HecVelaz/Proyecto-Mburica-/02_Estacion/Proyecto3__Sistema_de_adquisiscion_de_Nivel/Evidencias_Pruebas/capturas/Base_de_datos_servidor.jpg

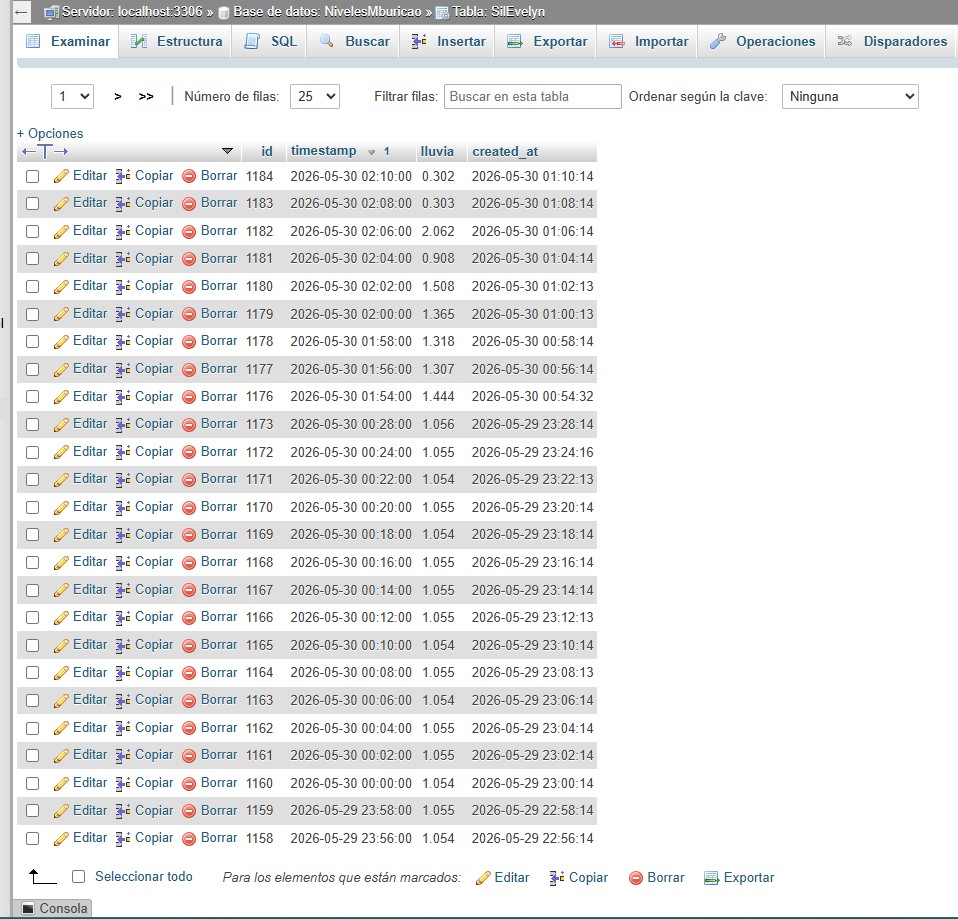
02_Estacion/Proyecto3__Sistema_de_adquisiscion_de_Nivel/Evidencias_Pruebas/capturas/Base_de_datos_servidor.jpg
