HecVelaz/Proyecto-Mburica-/02_Estacion/Proyecto3__Sistema_de_adquisiscion_de_Nivel/Evidencias_Pruebas/capturas/Montaje_sistema.jpg

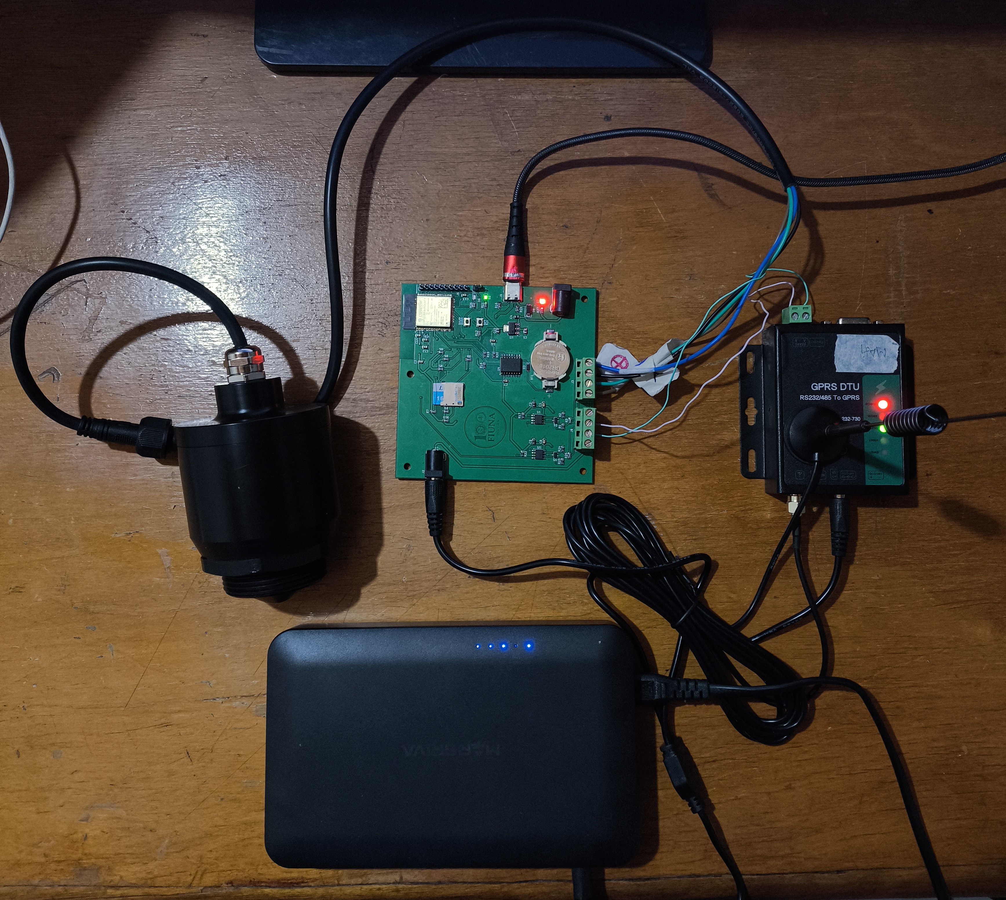
02_Estacion/Proyecto3__Sistema_de_adquisiscion_de_Nivel/Evidencias_Pruebas/capturas/Montaje_sistema.jpg
