HecVelaz/Proyecto-Mburica-/README.md

# Proyecto-Mburica-
Repositorio central del Proyecto Mburicao: Sistema IoT de monitoreo de nivel de cauces, modelos de predicción con IA y documentación científica
