HecVelaz/Proyecto-Mburica-/02_Estacion/Proyecto3__Sistema_de_adquisiscion_de_Nivel/Hardware_Kicad/placa_estacion/placa_estacion.md

## Propósito
En ésta carpeta se encuentran los archivos referentes al diseño del PCB para la placa de la estación
se utilizó la aplicación de escritorio EasyEDA, también se hizo la prueba con KiCAD pero finalmente se optó por EasyEDA.

## Contenido

- [[ESTACION2.rar]]
