HecVelaz/Proyecto-Mburica-/01_Modelos/notebooks/notebooks.md

[[aisp]]
[[csv_to_excel]]
[[features]]
[[Map Heat]]
[[merged]]
[[nivel]]
[[sil]]
[[snd]]
