HecVelaz/Proyecto-Mburica-/01_Modelos/notebooks/Map Heat/Map Heat.md

## Propósito
Alojamiento para guardar las imágenes del Cross Correlation de cada stación snd , aisp , sil
además del script Cross-Correlation-Map-Heat.ipynb

## Contenido
- [`Cross-Correlation-Map-Heat.ipynb`](notebooks/Map%20Heat/Cross-Correlation-Map-Heat.ipynb)
- [heatmap.png](heatmap.png)
- [heatmap_aisp_adjusted_bold_labels.png](heatmap_aisp_adjusted_bold_labels.png)
- [heatmap_sil_adjusted_bold_labels.png](heatmap_sil_adjusted_bold_labels.png)
- [heatmap_snd_adjusted_bold_labels.png](heatmap_snd_adjusted_bold_labels.png)
## Archivos relevantes

### Datos
- sin datos

### Notebooks
- [`Cross-Correlation-Map-Heat.ipynb`](notebooks/Map%20Heat/Cross-Correlation-Map-Heat.ipynb)

## Flujo de uso
Cómo se usan estos archivos en conjunto.
## Entradas
- 3 listas para cada estación 

## Salidas
- grafico mapa de calor de a cuerdo a la lista de entrada

## Observaciones
- Supuestos
- Limitaciones
- Notas importantes
