HecVelaz/Proyecto-Mburica-/01_Modelos/FORMATO.md

# <Nombre de la carpeta / módulo>

## Propósito
Breve descripción de qué contiene esta carpeta y qué rol cumple
dentro del proyecto.

## Contenido
Descripción general de los tipos de archivos que se encuentran aquí.

- Archivos de datos (`.csv`)
- Notebooks de procesamiento/análisis (`.ipynb`)
- Otros recursos (si aplica)

## Archivos relevantes

### Datos
- `<archivo1>.csv` — breve descripción
- `<archivo2>.csv` — breve descripción

### Notebooks
- `<script1>.ipynb` — qué hace a alto nivel
- `<script2>.ipynb` — qué hace a alto nivel

## Flujo de uso
Cómo se usan estos archivos en conjunto.

Ejemplo:
1. Se cargan los datos desde `<archivo>.csv`.
2. Se procesan mediante `<script>.ipynb`.
3. Se generan resultados en otra carpeta.

## Entradas
- Carpeta(s) o archivo(s) de los que depende este módulo.

## Salidas
- Carpeta(s) o archivo(s) que se generan a partir de este módulo.

## Observaciones
- Supuestos
- Limitaciones
- Notas importantes
