HecVelaz/Proyecto-Mburica-/01_Modelos/publicaciones/publicaciones.md

## Propósito
Archivos respecto a las publicaciones hechas respecto al proyecto
poster presentado en el año 2024  [[poster2024]]
y artículo presentado en el 2025 [[CLEI2025]]
