HecVelaz/Proyecto-Mburica-/01_Modelos/data/interim/interim.md

## Propósito
Ésta es la carpeta que contiene los 4 datos revisados de la carpeta raw , utilizamos el mismo nombre , ya que técnicamente son los mismos datos , sin ningún tipo de modificaciones. Solo que los datos pasaron por las revisiones correspondientes. Solo se cambió el nombre de las columnas 

## Archivos disponibles

- `aisp.csv`  precipitación aeropuerto silvio pettirossi.
- `nivel.csv`  nivel de lluvia arroyo Mburicaó.
- `sil.csv`  precipitación san ignacio de loyola school.
- `snd.csv`  precipitación secretaria nacional de deportes.
