HecVelaz/Proyecto-Mburica-/01_Modelos/data/raw/raw.md

# Carpeta `raw`

## Propósito
Inicialmente , los datos nivel, snd y aisp venían todos en pestañas separadas en un mismo documento excel en formato xlsx, entonces, separamos cada pestaña y lo hicimos independientes sin modificar ninguna caracteristicas de los datos.
El archivo sil , no forma parte de este conjunto. Por lo tanto, quedan 4 archivos .csv 
Contiene los datos originales del proyecto en formato CSV.
Estos archivos no deben ser modificados.

## Archivos disponibles

- `aisp.csv`  precipitación aeropuerto silvio pettirossi.
- `nivel.csv`  nivel de lluvia arroyo Mburicaó.
- `sil.csv`  precipitación san ignacio de loyola school.
- `snd.csv`  precipitación secretaria nacional de deportes.

Cada archivo representa un conjunto de mediciones diferente.

## Visualizaciones
- `nivel_plot_overview.png`  
  Imagen exploratoria generada a partir de `nivel.csv`.
