HecVelaz/Proyecto-Mburica-/01_Modelos/docs/visualizacion/visualizacion.md

## Propósito
Se guardan imagenes dentro de las carpetas:
[[mburicao]]
[[docs/visualizacion/merged/merged]]
[[model]]
[[station]]
