HecVelaz/Proyecto-Mburica-/01_Modelos/notebooks/merged/merged.md

Aquí se realiza el Cross Correlation y el Mutual information
