HecVelaz/Proyecto-Mburica-/01_Modelos/scr/data/data.md

## Propósito
Datos que se generaron para el modelo

## Contenido
Descripción general de los tipos de archivos que se encuentran aquí.

- [data_extraction.csv](/scr/data/data_extraction.csv)
- [data_for_clustering.csv](/scr/data/data_for_clustering.csv)
- [data_for_clustering_1.csv](/scr/data/data_for_clustering_1.csv)
- [data_for_clustering_1_5.csv](/scr/data/data_for_clustering_1_5.csv)
- [data_for_clustering_2.csv](/scr/data/data_for_clustering_2.csv)
- [duration_event_and_peak.csv](/scr/data/duration_event_and_peak.csv)
- [peaks_counts_dates.csv](/scr/data/peaks_counts_dates.csv)

## Archivos relevantes

### Datos
- [data_extraction.csv](/scr/data/data_extraction.csv)
- [data_for_clustering.csv](/scr/data/data_for_clustering.csv)
- [data_for_clustering_1.csv](/scr/data/data_for_clustering_1.csv)
- [data_for_clustering_1_5.csv](/scr/data/data_for_clustering_1_5.csv)
- [data_for_clustering_2.csv](/scr/data/data_for_clustering_2.csv)
- [duration_event_and_peak.csv](/scr/data/duration_event_and_peak.csv)
- [peaks_counts_dates.csv](/scr/data/peaks_counts_dates.csv)
