HecVelaz/Proyecto-Mburica-/02_Estacion/Sistema_modular/Moden/Moden.md

## Propósito
Aquí se guarda el software del moden utilizado , también 2 pdfs que pueden ayudar a la programación , se utilizó comdanos AT para la configuración del moden 

## Contenido
- [[USR-GM3-Setup-Software_V1.2.1.101.exe]]
- [[Gm3Cfg.ini]]
- [[Gm3Lang.txt]]
- ![[USR-GPRS232-730-Guide-Line_V1.0.13.01.pdf]]
- ![[USR-GPRS232-730&734-AT commands V1.0.0.pdf]]
