HecVelaz/Proyecto-Mburica-/01_Modelos/notebooks/nivel/peaks/peaks.md

## Propósito
Éste script sirve para crear un conjunto de datos que tendrán los tiempos y el nivel de los picos encontrados.

## Contenido

- [peak_detection.ipynb](/notebooks/nivel/peaks/peak_detection.ipynb)

## Archivos relevantes

### Datos
- sin datos

### Notebooks
- [peak_detection.ipynb](/notebooks/nivel/peaks/peak_detection.ipynb):
	- Se carga [nivel_processed.csv](/data/processed/nivel_processed.csv)
	- Se aplica un algoritmo para encontrar los picos 
	- salida [peak_nivel_detection.csv](/data/external/peak_nivel_detection.csv)

## Entradas
- [nivel_processed.csv](/data/processed/nivel_processed.csv)

## Salidas
- [peak_nivel_detection.csv](/data/external/peak_nivel_detection.csv)
