HecVelaz/Proyecto-Mburica-/01_Modelos/data/raw/nivel_plot_overview.png

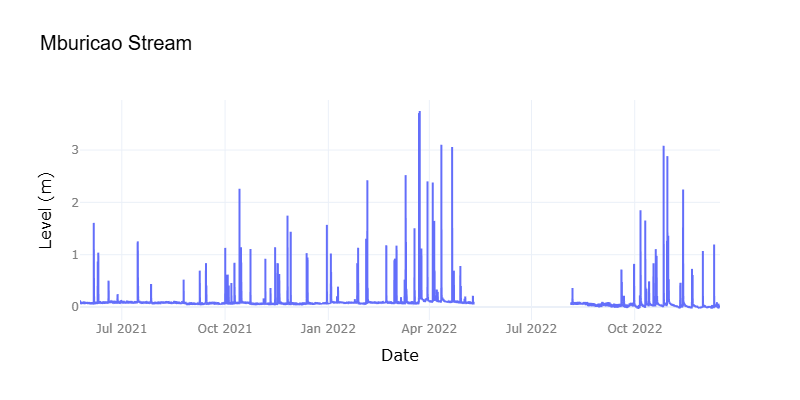
01_Modelos/data/raw/nivel_plot_overview.png
