HecVelaz/Proyecto-Mburica-/01_Modelos/docs/visualizacion/mburicao/local_global_peak.png

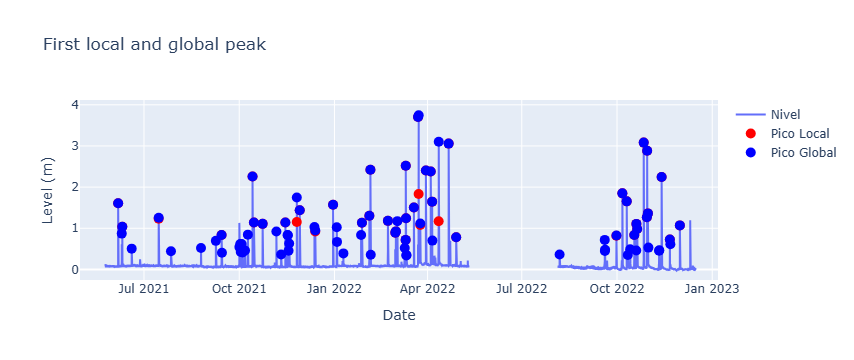
01_Modelos/docs/visualizacion/mburicao/local_global_peak.png
