HecVelaz/Proyecto-Mburica-/01_Modelos/docs/visualizacion/merged/aisp_nivel_merged_plot.png

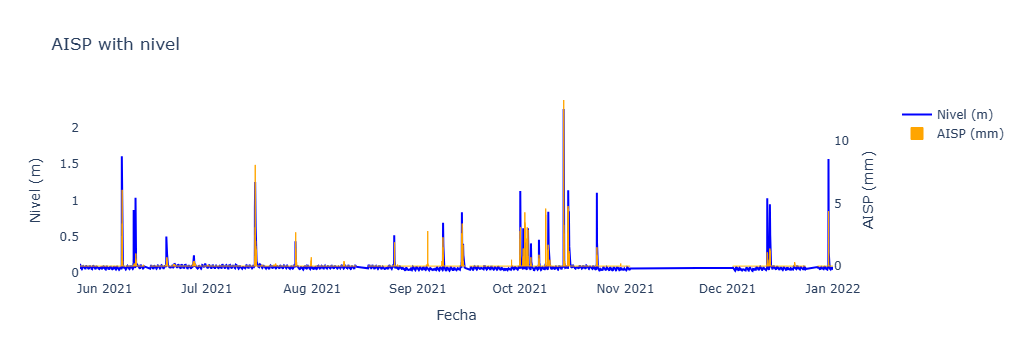
01_Modelos/docs/visualizacion/merged/aisp_nivel_merged_plot.png
