HecVelaz/Proyecto-Mburica-/01_Modelos/docs/visualizacion/merged/cross_correlation/sil_nivel_cross_correlation.png

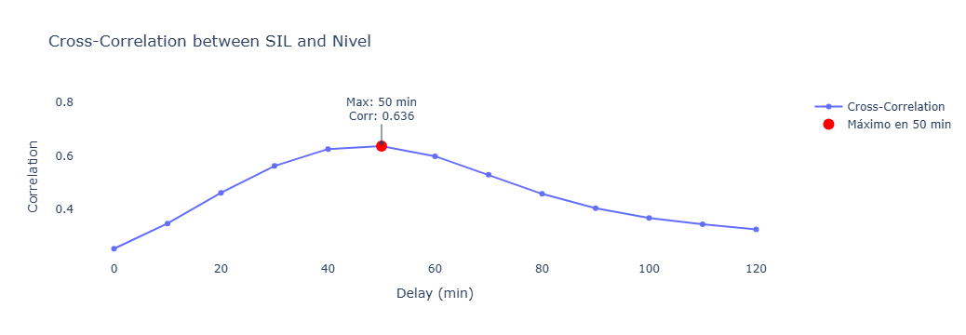
01_Modelos/docs/visualizacion/merged/cross_correlation/sil_nivel_cross_correlation.png
