HecVelaz/Proyecto-Mburica-/01_Modelos/docs/visualizacion/merged/cross_correlation/snd_local_merged_cross_correlation.png

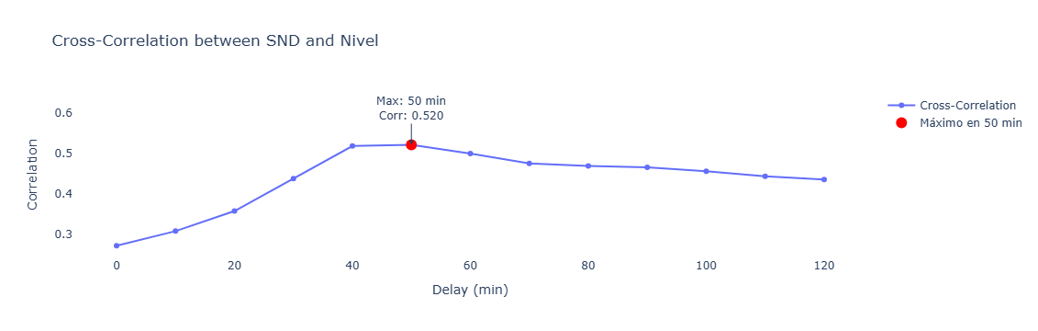
01_Modelos/docs/visualizacion/merged/cross_correlation/snd_local_merged_cross_correlation.png
