HecVelaz/Proyecto-Mburica-/01_Modelos/docs/visualizacion/merged/sil_nivel_merged_event_plot.png

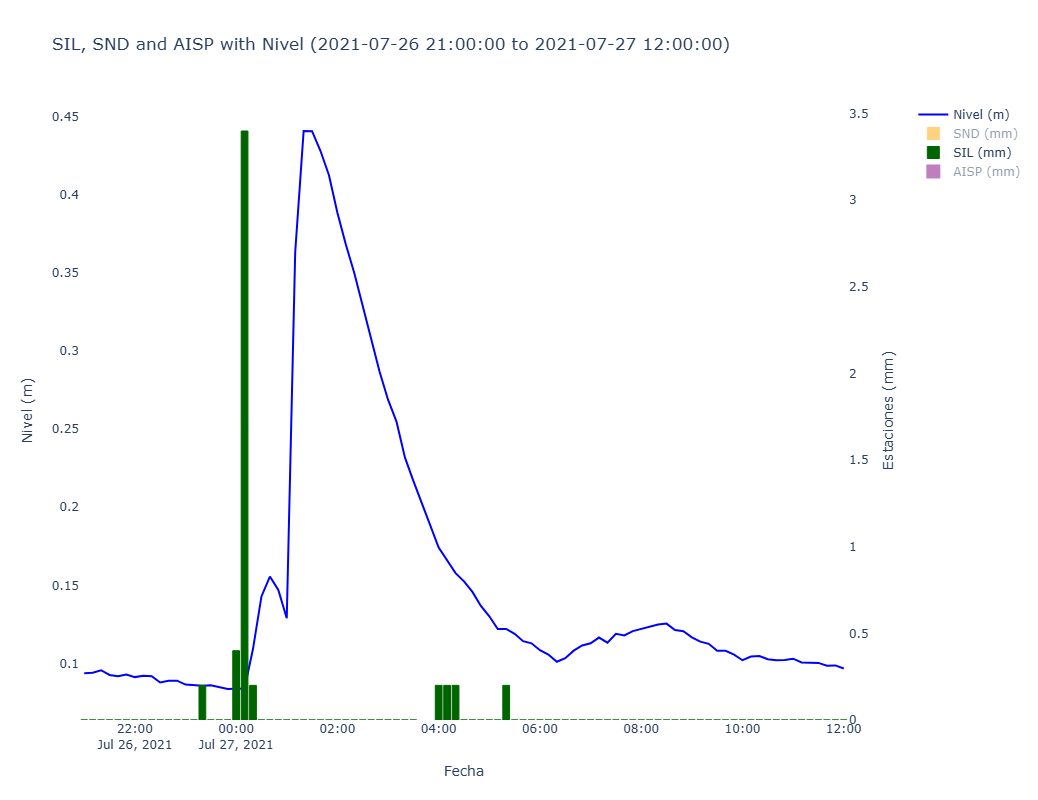
01_Modelos/docs/visualizacion/merged/sil_nivel_merged_event_plot.png
