HecVelaz/Proyecto-Mburica-/01_Modelos/docs/visualizacion/merged/sil_nivel_merged_peaks.png

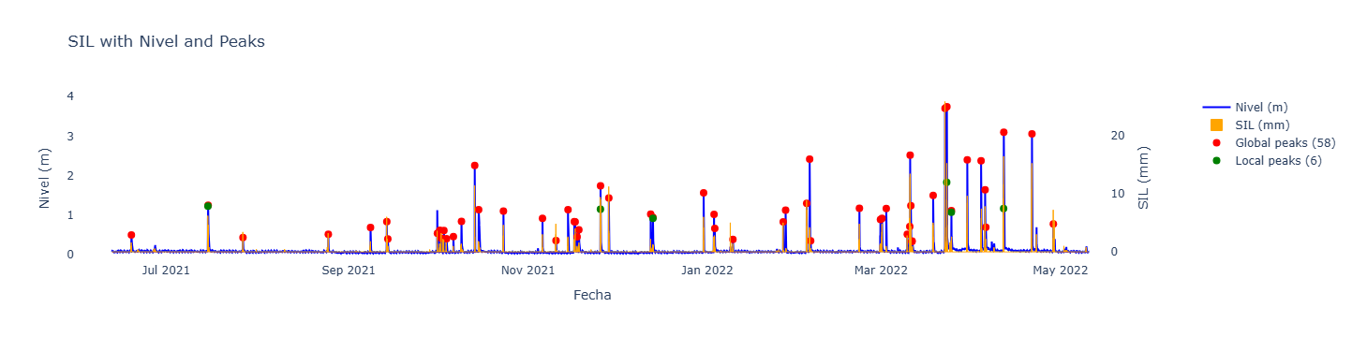
01_Modelos/docs/visualizacion/merged/sil_nivel_merged_peaks.png
