HecVelaz/Proyecto-Mburica-/01_Modelos/docs/visualizacion/station/sil_plot_overview.png

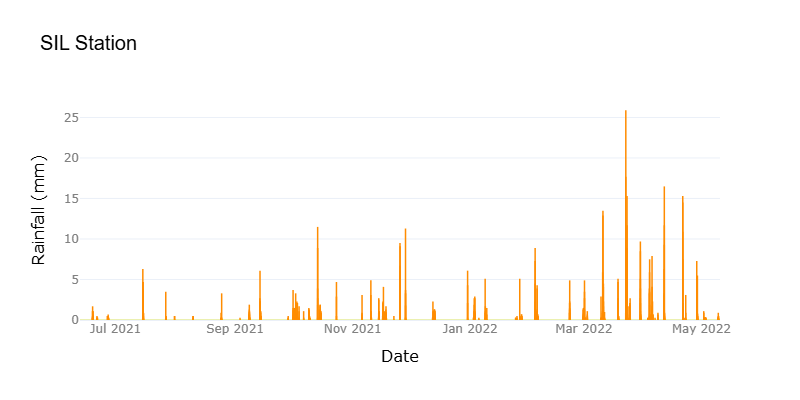
01_Modelos/docs/visualizacion/station/sil_plot_overview.png
