HecVelaz/Proyecto-Mburica-/01_Modelos/notebooks/Map Heat/heatmap.png

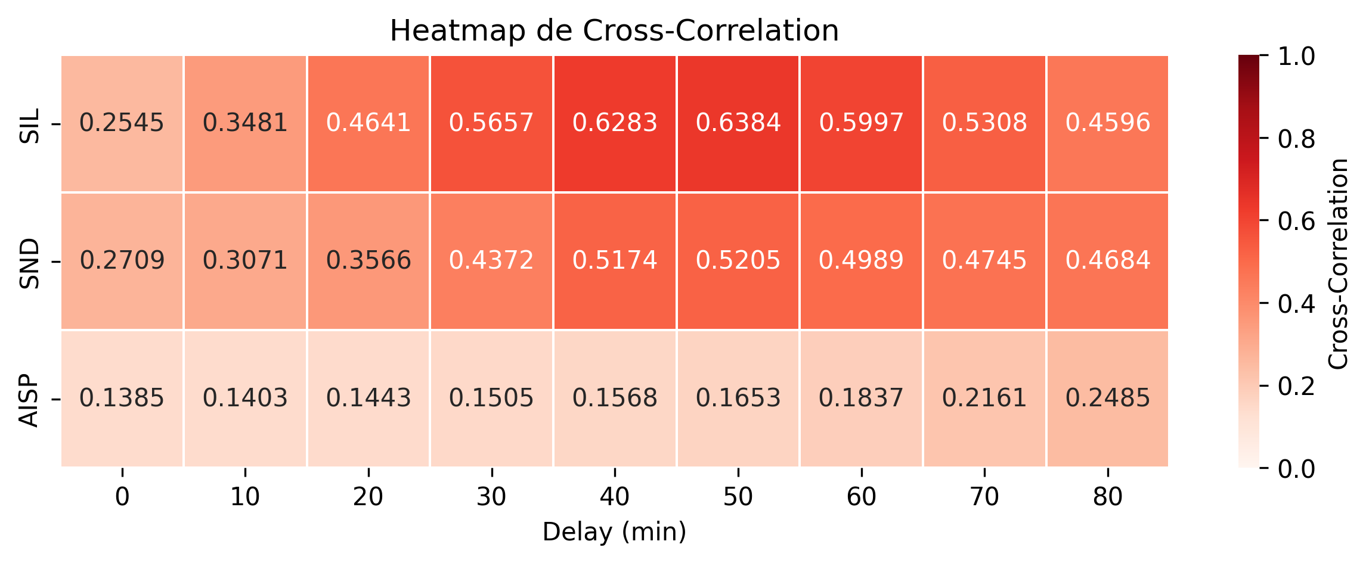
01_Modelos/notebooks/Map Heat/heatmap.png
