HecVelaz/Proyecto-Mburica-/01_Modelos/notebooks/Map Heat/heatmap_aisp_adjusted_bold_labels.png

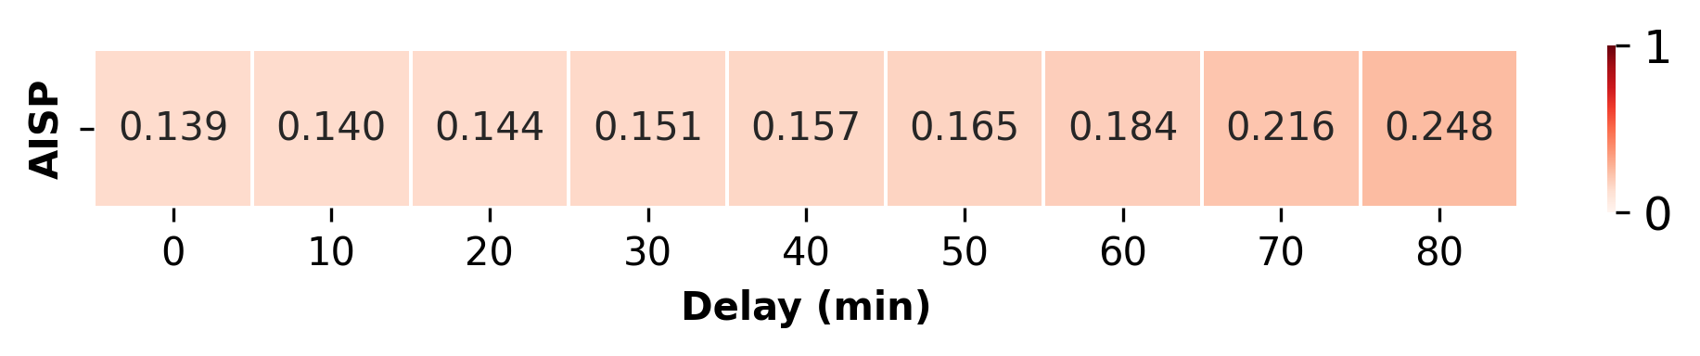
01_Modelos/notebooks/Map Heat/heatmap_aisp_adjusted_bold_labels.png
