HecVelaz/Proyecto-Mburica-/01_Modelos/scr/models/Multilinear_Regression_Analysis.png

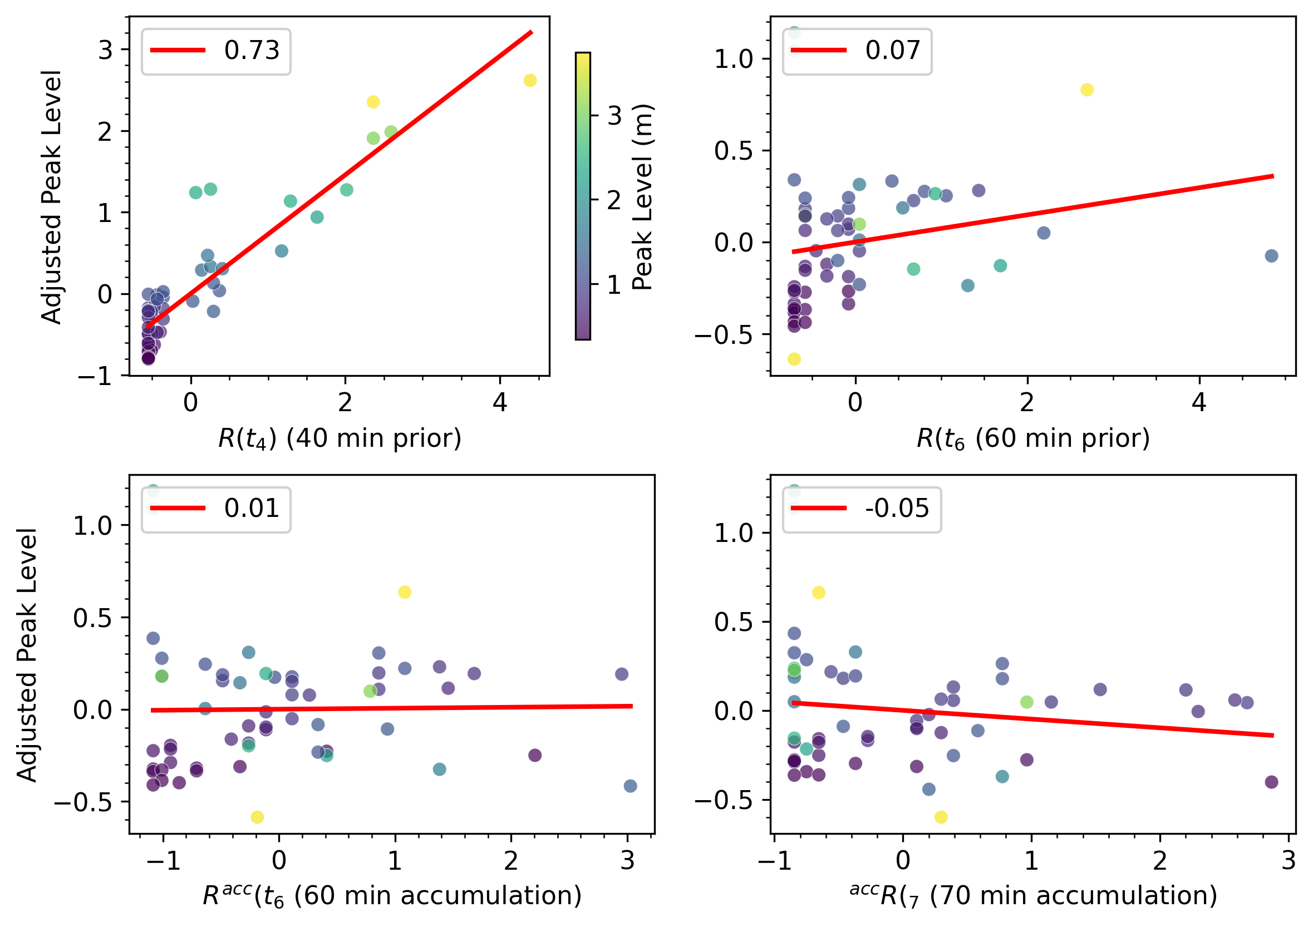
01_Modelos/scr/models/Multilinear_Regression_Analysis.png
