HecVelaz/Proyecto-Mburica-/03_Datos_obtenidos/27_08to06_09.png

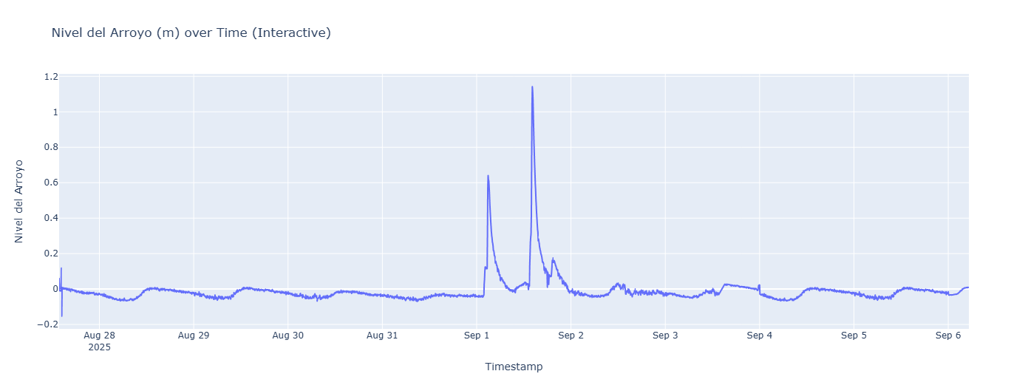
03_Datos_obtenidos/27_08to06_09.png
