HecVelaz/Proyecto-Mburica-/02_Estacion/Proyecto3__Sistema_de_adquisiscion_de_Nivel/Evidencias_Pruebas/videos/README.md

# Videos de pruebas

Los videos de prueba se encuentran alojados externamente en Google Drive para evitar aumentar el tamaño del repositorio. En esta carpeta se listan los enlaces a las evidencias audiovisuales utilizadas para verificar el funcionamiento de los módulos y del sistema integrado.

## Lista de videos

| N.º | Prueba | Descripción | Enlace |
| --- | --- | --- | --- |
| 1 | Prueba del LED azul | Verificación del LED indicador utilizado para señalar una lectura válida del sensor de nivel. | [Ver video](https://drive.google.com/file/d/1yZTbWLAMQBHtrM2hwZs7zqRO-RH48-HB/view?usp=drive_link) |
| 2 | Prueba de tarjeta microSD | Verificación de la detección de la tarjeta microSD y del funcionamiento del conector utilizado en la placa. | [Ver video](https://drive.google.com/file/d/19R5aCAA-6pBu098gMMyVXceTk3J7X_a-/view?usp=drive_link) |
| 3 | Prueba del RTC DS3231 | Configuración y lectura correcta de la fecha y hora desde el RTC DS3231 mediante comunicación I2C. | [Ver video](https://drive.google.com/file/d/1AH5-atD6chmUB5mobT-IkS_jdaVtZ49u/view?usp=drive_link) |
| 4 | Prueba del sistema integrado | Funcionamiento conjunto del sensor de nivel RS485, RTC DS3231, tarjeta microSD, módem DTU, LED indicador y firmware principal. | [Ver video](https://drive.google.com/file/d/1fyCeK_l0-00xuTfR_rccq4oqjixhjDV9/view?usp=drive_link) |
| 5 | Prueba Store and Forward | Prueba del mecanismo de almacenamiento y reenvío de datos pendientes cuando ocurre una falla temporal de comunicación. | [Ver video](https://drive.google.com/file/d/12kTLneO2Io2DWGPuWARCHy4YUeFoKbM6/view?usp=drive_link) |

## Observación

Los videos complementan las capturas y resultados presentados en el informe técnico. Su objetivo es evidenciar visualmente el funcionamiento de los módulos principales y del sistema completo durante las pruebas de validación.
