HecVelaz/Proyecto-Mburica-/01_Modelos/scr/evaluation/evaluation.md

## Propósito
Breve descripción de qué contiene esta carpeta y qué rol cumple
dentro del proyecto.

## Contenido
Descripción general de los tipos de archivos que se encuentran aquí.

-  [LR_best_features_mape.csv](/scr/evaluation/LR_best_features_mape.csv)
- [LR_best_features_r2.csv](/scr/evaluation/LR_best_features_r2.csv)
- [LR_best_features_rmse.csv](/scr/evaluation/LR_best_features_rmse.csv)
- [SVM_best_features_f1.csv](/scr/evaluation/SVM_best_features_f1.csv)
- [SVM_best_features_f1_1.csv](/scr/evaluation/SVM_best_features_f1_1.csv)
- [SVM_best_features_f1_1_5.csv](/scr/evaluation/SVM_best_features_f1_1_5.csv)
- [SVM_best_features_f1_2.csv](/scr/evaluation/SVM_best_features_f1_2.csv)
- [SVM_best_features_fn.csv](/scr/evaluation/SVM_best_features_fn.csv)
- [SVM_best_features_fn_1.csv](/scr/evaluation/SVM_best_features_fn_1.csv)
- [SVM_best_features_fn_1_5.csv](/scr/evaluation/SVM_best_features_fn_1_5.csv)
- [SVM_best_features_fn_2.csv](/scr/evaluation/SVM_best_features_fn_2.csv)
- [SVM_best_features_precision.csv](/scr/evaluation/SVM_best_features_precision.csv)
- [SVM_best_features_precision_1.csv](/scr/evaluation/SVM_best_features_precision_1.csv)
- [SVM_best_features_precision_1_5.csv](/scr/evaluation/SVM_best_features_precision_1_5.csv)
- [SVM_best_features_precision_2.csv](/scr/evaluation/SVM_best_features_precision_2.csv)
- [SVM_best_features_recall.csv](/scr/evaluation/SVM_best_features_recall.csv)
- [SVM_best_features_recall_1.csv](/scr/evaluation/SVM_best_features_recall_1.csv)
- [SVM_best_features_recall_1_5.csv](/scr/evaluation/SVM_best_features_recall_1_5.csv)
- [SVM_best_features_recall_2.csv](/scr/evaluation/SVM_best_features_recall_2.csv)

## Archivos relevantes

### Datos
- `<archivo1>.csv` — breve descripción
- `<archivo2>.csv` — breve descripción

### Notebooks
- `<script1>.ipynb` — qué hace a alto nivel
- `<script2>.ipynb` — qué hace a alto nivel

## Flujo de uso
Cómo se usan estos archivos en conjunto.

Ejemplo:
1. Se cargan los datos desde `<archivo>.csv`.
2. Se procesan mediante `<script>.ipynb`.
3. Se generan resultados en otra carpeta.

## Entradas
- Carpeta(s) o archivo(s) de los que depende este módulo.

## Salidas
- Carpeta(s) o archivo(s) que se generan a partir de este módulo.
