HecVelaz/Proyecto-Mburica-/01_Modelos/scr/evaluation/excel/excel.md

## Propósito
Pasar a excel los datos seleccionados de la carpeta evaluation

## Contenido

- [LR_best_features_r2_excel.xlsx](/scr/evaluation/excel/LR_best_features_r2_excel.xlsx)
- [SVM_best_features_fn_excel.xlsx](/scr/evaluation/excel/SVM_best_features_fn_excel.xlsx)
- [SVM_best_features_fn_excel_1.xlsx](/scr/evaluation/excel/SVM_best_features_fn_excel_1.xlsx)
- [SVM_best_features_fn_excel_1_5.xlsx](/scr/evaluation/excel/SVM_best_features_fn_excel_1_5.xlsx)
- [SVM_best_features_fn_excel_2.xlsx](/scr/evaluation/excel/SVM_best_features_fn_excel_2.xlsx)
