HecVelaz/Proyecto-Mburica-/01_Modelos/scr/evaluation/excel/LR_best_features_r2_excel.xlsx

window | n_features | best_features | R2 | RMSE | MAPE
1 | 4 | ('sil_70', 'sil_80', 'sil_accumulated_10', 'sil_accumulated_70') | 0.8411890387 | 0.3303931646 | 0.2760627062
2 | 4 | ('sil_50', 'sil_70', 'sil_accumulated_20', 'sil_accumulated_70') | 0.8442868871 | 0.3271548854 | 0.2807232372
3 | 4 | ('sil_50', 'sil_70', 'sil_accumulated_30', 'sil_accumulated_70') | 0.8469709241 | 0.3243230342 | 0.2818797142
4 | 4 | ('sil_40', 'sil_60', 'sil_accumulated_60', 'sil_accumulated_70') | 0.8208771952 | 0.3508861749 | 0.3127088563
5 | 1 | ('sil_50',) | 0.6138831781 | 0.5151695413 | 0.3671953916
6 | 2 | ('sil_70', 'sil_accumulated_60') | 0.04783874945 | 0.8089954298 | 0.7372087252
7 | 1 | ('sil_70',) | 0.0194200929 | 0.8209794975 | 0.763910603
