HecVelaz/Proyecto-Mburica-/01_Modelos/scr/evaluation/excel/SVM_best_features_fn_excel.xlsx

window | n_features | best_features | FN | precision | recall | f1
0 | 5 | ('sil_0', 'sil_10', 'sil_40', 'sil_50', 'sil_accumulated_30') | 13 | 0.9189189189 | 0.7234042553 | 0.8095238095
1 | 4 | ('sil_40', 'sil_50', 'sil_accumulated_10', 'sil_accumulated_30') | 12 | 0.9210526316 | 0.7446808511 | 0.8235294118
2 | 2 | ('sil_50', 'sil_accumulated_20') | 14 | 0.9166666667 | 0.7021276596 | 0.7951807229
3 | 3 | ('sil_40', 'sil_50', 'sil_accumulated_30') | 21 | 0.8965517241 | 0.5531914894 | 0.6842105263
4 | 1 | ('sil_accumulated_40',) | 32 | 0.9375 | 0.3191489362 | 0.4761904762
5 | 1 | ('sil_50',) | 34 | 0.8666666667 | 0.2765957447 | 0.4193548387
