HecVelaz/Proyecto-Mburica-/01_Modelos/scr/evaluation/excel/SVM_best_features_fn_excel_1.xlsx

window | n_features | best_features | FN | precision | recall | f1
0 | 3 | ('sil_0', 'sil_10', 'sil_accumulated_30') | 5 | 0.75 | 0.8076923077 | 0.7777777778
1 | 4 | ('sil_20', 'sil_30', 'sil_50', 'sil_accumulated_10') | 5 | 0.84 | 0.8076923077 | 0.8235294118
2 | 4 | ('sil_20', 'sil_40', 'sil_accumulated_30', 'sil_accumulated_40') | 6 | 0.7692307692 | 0.7692307692 | 0.7692307692
3 | 2 | ('sil_30', 'sil_50') | 14 | 0.8571428571 | 0.4615384615 | 0.6
4 | 3 | ('sil_40', 'sil_50', 'sil_accumulated_50') | 5 | 0.525 | 0.8076923077 | 0.6363636364
5 | 1 | ('sil_50',) | 4 | 0.5365853659 | 0.8461538462 | 0.6567164179
