HecVelaz/Proyecto-Mburica-/01_Modelos/scr/evaluation/excel/SVM_best_features_fn_excel_1_5.xlsx

window | n_features | best_features | FN | precision | recall | f1
0 | 3 | ('sil_0', 'sil_20', 'sil_40') | 2 | 0.6111111111 | 0.8461538462 | 0.7096774194
1 | 2 | ('sil_40', 'sil_accumulated_10') | 2 | 0.6111111111 | 0.8461538462 | 0.7096774194
2 | 2 | ('sil_50', 'sil_accumulated_20') | 2 | 0.5789473684 | 0.8461538462 | 0.6875
3 | 5 | ('sil_40', 'sil_50', 'sil_accumulated_30', 'sil_accumulated_40', 'sil_accumulated_50') | 2 | 0.3142857143 | 0.8461538462 | 0.4583333333
4 | 1 | ('sil_40',) | 1 | 0.2926829268 | 0.9230769231 | 0.4444444444
5 | 1 | ('sil_50',) | 2 | 0.3333333333 | 0.8461538462 | 0.4782608696
