HecVelaz/Proyecto-Mburica-/01_Modelos/scr/evaluation/excel/SVM_best_features_fn_excel_2.xlsx

window | n_features | best_features | FN | precision | recall | f1
0 | 3 | ('sil_0', 'sil_20', 'sil_40') | 2 | 0.4375 | 0.7777777778 | 0.56
1 | 2 | ('sil_accumulated_10', 'sil_accumulated_40') | 1 | 0.5 | 0.8888888889 | 0.64
2 | 1 | ('sil_20',) | 2 | 0.4117647059 | 0.7777777778 | 0.5384615385
3 | 4 | ('sil_40', 'sil_50', 'sil_accumulated_30', 'sil_accumulated_50') | 1 | 0.2285714286 | 0.8888888889 | 0.3636363636
4 | 1 | ('sil_40',) | 1 | 0.1739130435 | 0.8888888889 | 0.2909090909
5 | 1 | ('sil_50',) | 1 | 0.2424242424 | 0.8888888889 | 0.380952381
