HecVelaz/Proyecto-Mburica-/01_Modelos/docs/visualizacion/model/LR/LR_best_features_mape_results_plot.png

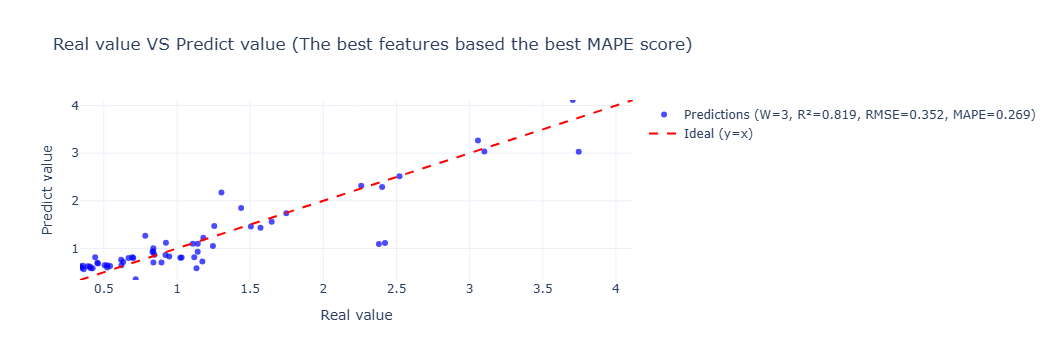
01_Modelos/docs/visualizacion/model/LR/LR_best_features_mape_results_plot.png
