HecVelaz/Proyecto-Mburica-/01_Modelos/docs/visualizacion/model/LR/LR_best_features_r2_results_plot.png

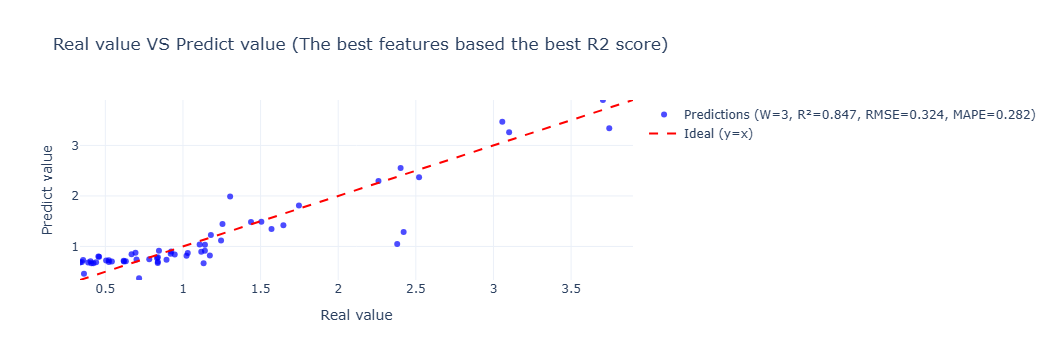
01_Modelos/docs/visualizacion/model/LR/LR_best_features_r2_results_plot.png
