HecVelaz/Proyecto-Mburica-/02_Estacion/Proyecto3__Sistema_de_adquisiscion_de_Nivel/Evidencias_Pruebas/capturas/apk_sensor.jpeg

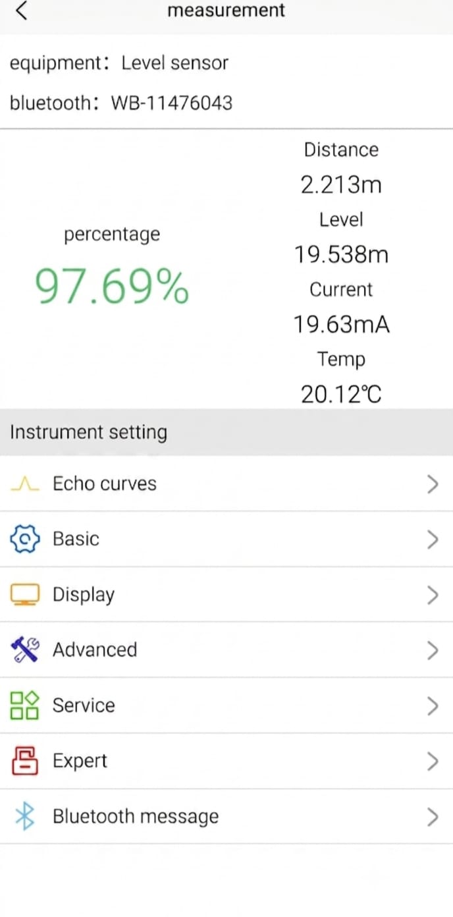
02_Estacion/Proyecto3__Sistema_de_adquisiscion_de_Nivel/Evidencias_Pruebas/capturas/apk_sensor.jpeg
