HecVelaz/Proyecto-Mburica-/02_Estacion/Proyecto3__Sistema_de_adquisiscion_de_Nivel/Hardware_Kicad/V1_Estacion_Nivel/Estacion_Nivel-B_Cu.pdf

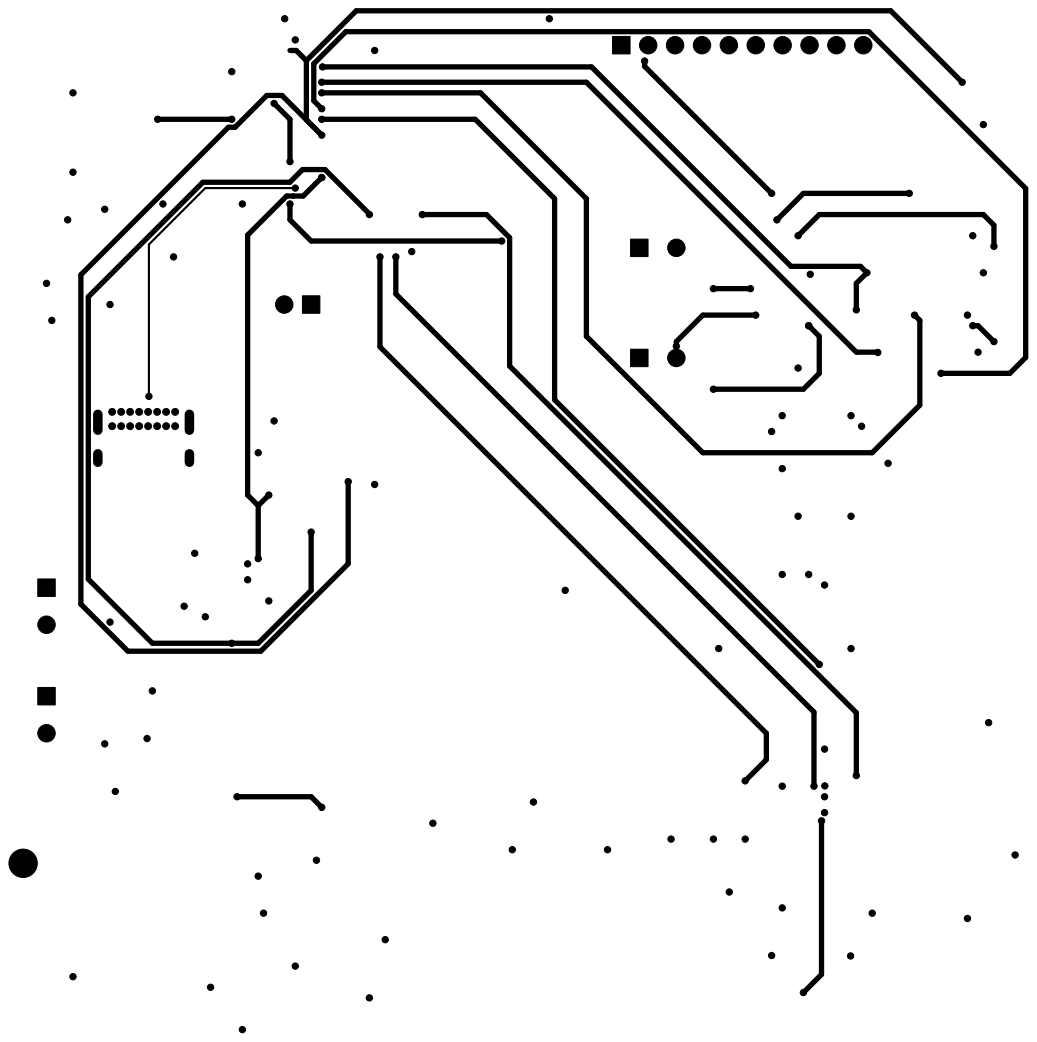
[picture p74: page 1]
