HecVelaz/Proyecto-Mburica-/02_Estacion/Proyecto3__Sistema_de_adquisiscion_de_Nivel/Hardware_Kicad/V1_Estacion_Nivel/Estacion_Nivel-B_Mask.pdf

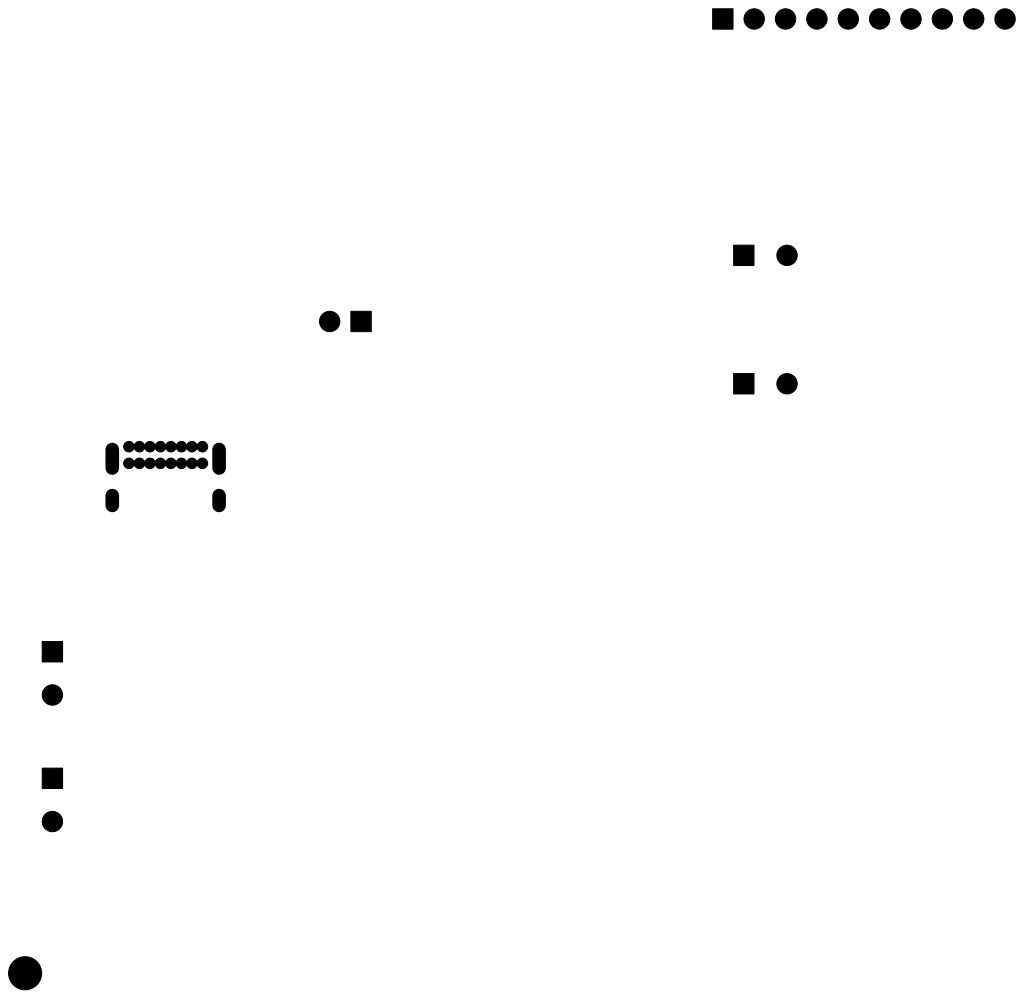
[picture p75: page 1]
