HecVelaz/Proyecto-Mburica-/02_Estacion/Proyecto3__Sistema_de_adquisiscion_de_Nivel/Hardware_Kicad/V1_Estacion_Nivel/Estacion_Nivel-F_Mask.pdf

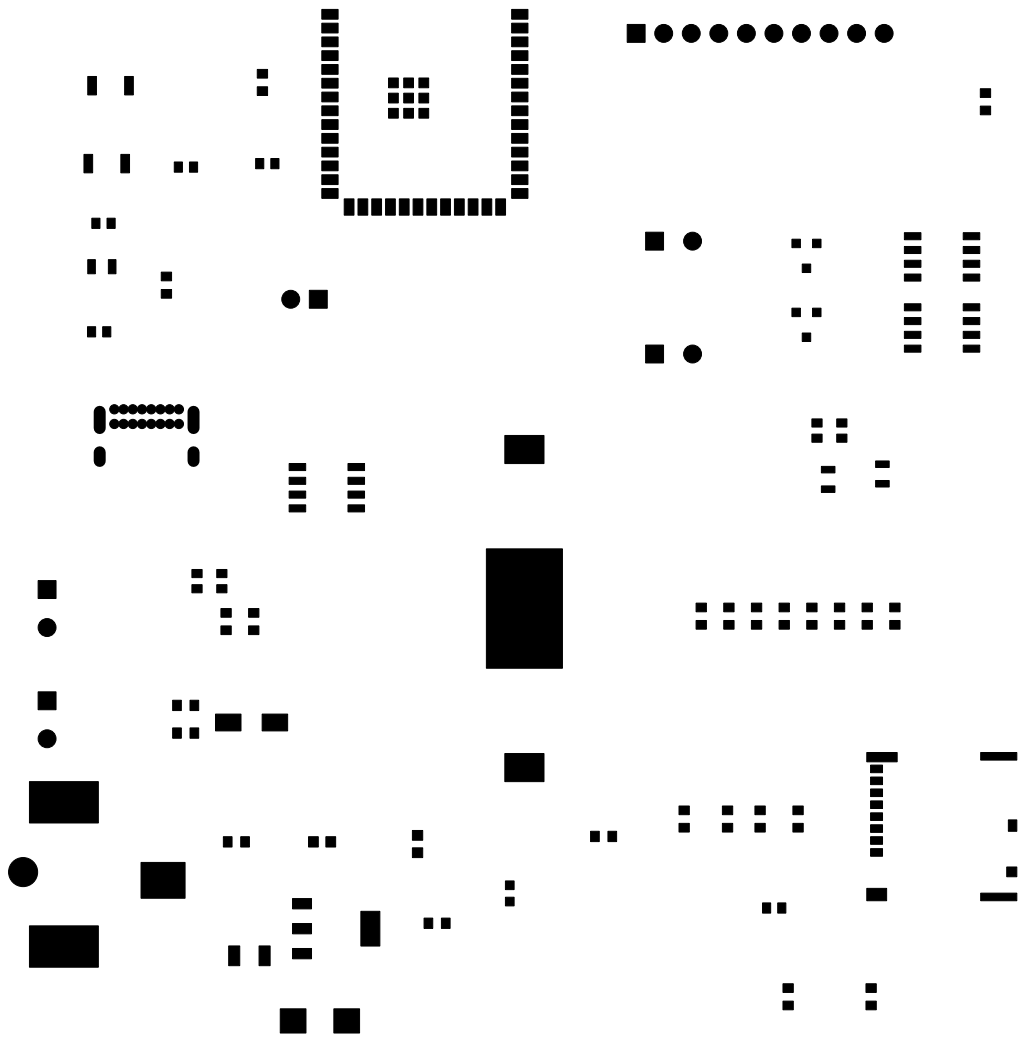
[picture p77: page 1]
