HecVelaz/Proyecto-Mburica-/02_Estacion/Proyecto3__Sistema_de_adquisiscion_de_Nivel/Hardware_Kicad/V1_Estacion_Nivel/Estacion_Nivel.kicad_pcb

## KiCad design 02_Estacion/Proyecto3__Sistema_de_adquisiscion_de_Nivel/Hardware_Kicad/V1_Estacion_Nivel/Estacion_Nivel.kicad_pcb (2026-07-13, an earlier design)

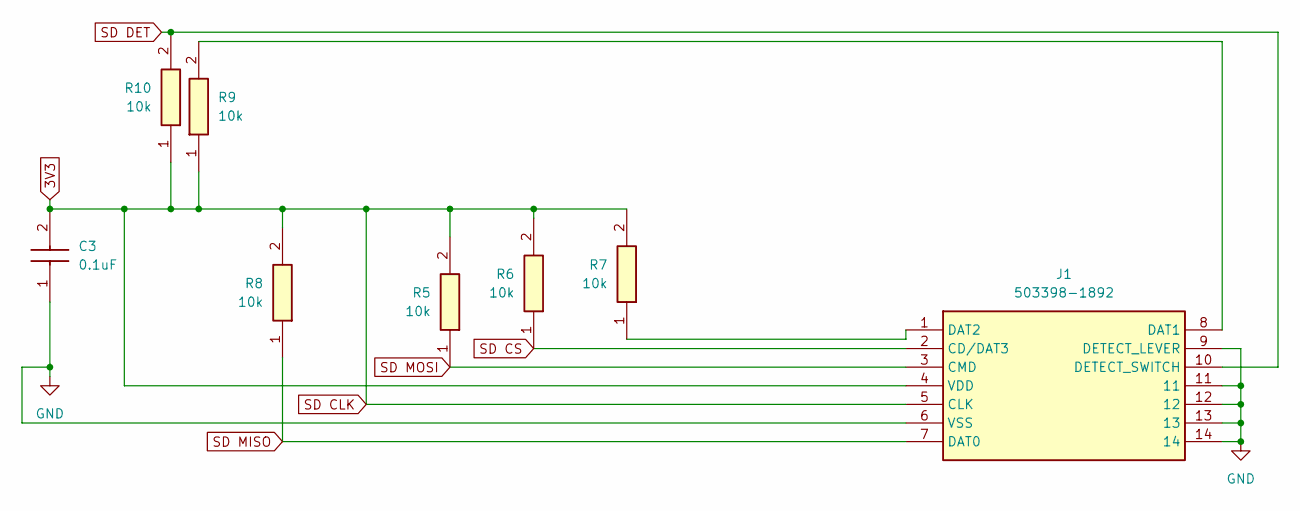
[picture p82: schematic sd_to_esp32.kicad_sch]

Parts:
C3: 0.1uF; CAPC1608X90N; Mouser Part Number 81-GCM188R71C104KA7D
J1: 503398-1892; 5033981892; Mouser Part Number 538-503398-1892
R5, R6, R7, R8, R9, R10: 10k; RESC1608X55N; Mouser Part Number 603-RC0603FR-0710KL

Connections:
unnamed: J1.8 (DAT1), R9.2
unnamed: J1.1 (DAT2), R7.1
SD CS: J1.2 (CD/DAT3), R6.1; also elsewhere on the board
SD DET: J1.10 (DETECT_SWITCH), R10.2; also elsewhere on the board
SD MISO: J1.7 (DAT0), R8.1; also elsewhere on the board
SD MOSI: J1.3 (CMD), R5.1; also elsewhere on the board

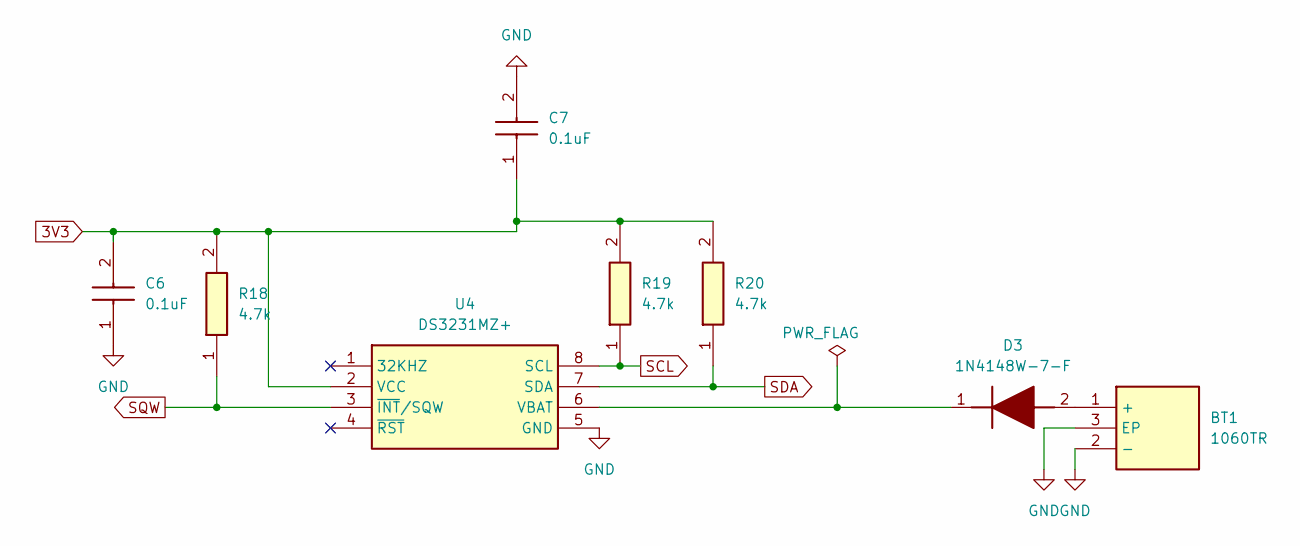
[picture p83: schematic DS3231.kicad_sch]

Parts:
BT1: 1060TR; Mouser Part Number 534-1060TR
C6, C7: 0.1uF; CAPC1608X90N; Mouser Part Number 81-GCM188R71C104KA7D
D3: 1N4148W-7-F; SOD3716X145N; Mouser Part Number 621-1N4148W-F
R18, R19, R20: 4.7k; RESC1608X55N; Mouser Part Number 603-RC0603FR-074K7L
U4: DS3231MZ+; SOIC127P600X175-8N; Mouser Part Number 700-DS3231MZ+

Connections:
unnamed: BT1.1 (+), D3.1 (K), D3.2 (A), U4.6 (VBAT)
SCL: R19.1, U4.8 (SCL); also elsewhere on the board
SDA: R20.1, U4.7 (SDA); also elsewhere on the board
SQW: R18.1, U4.3 (~INT/SQW); also elsewhere on the board

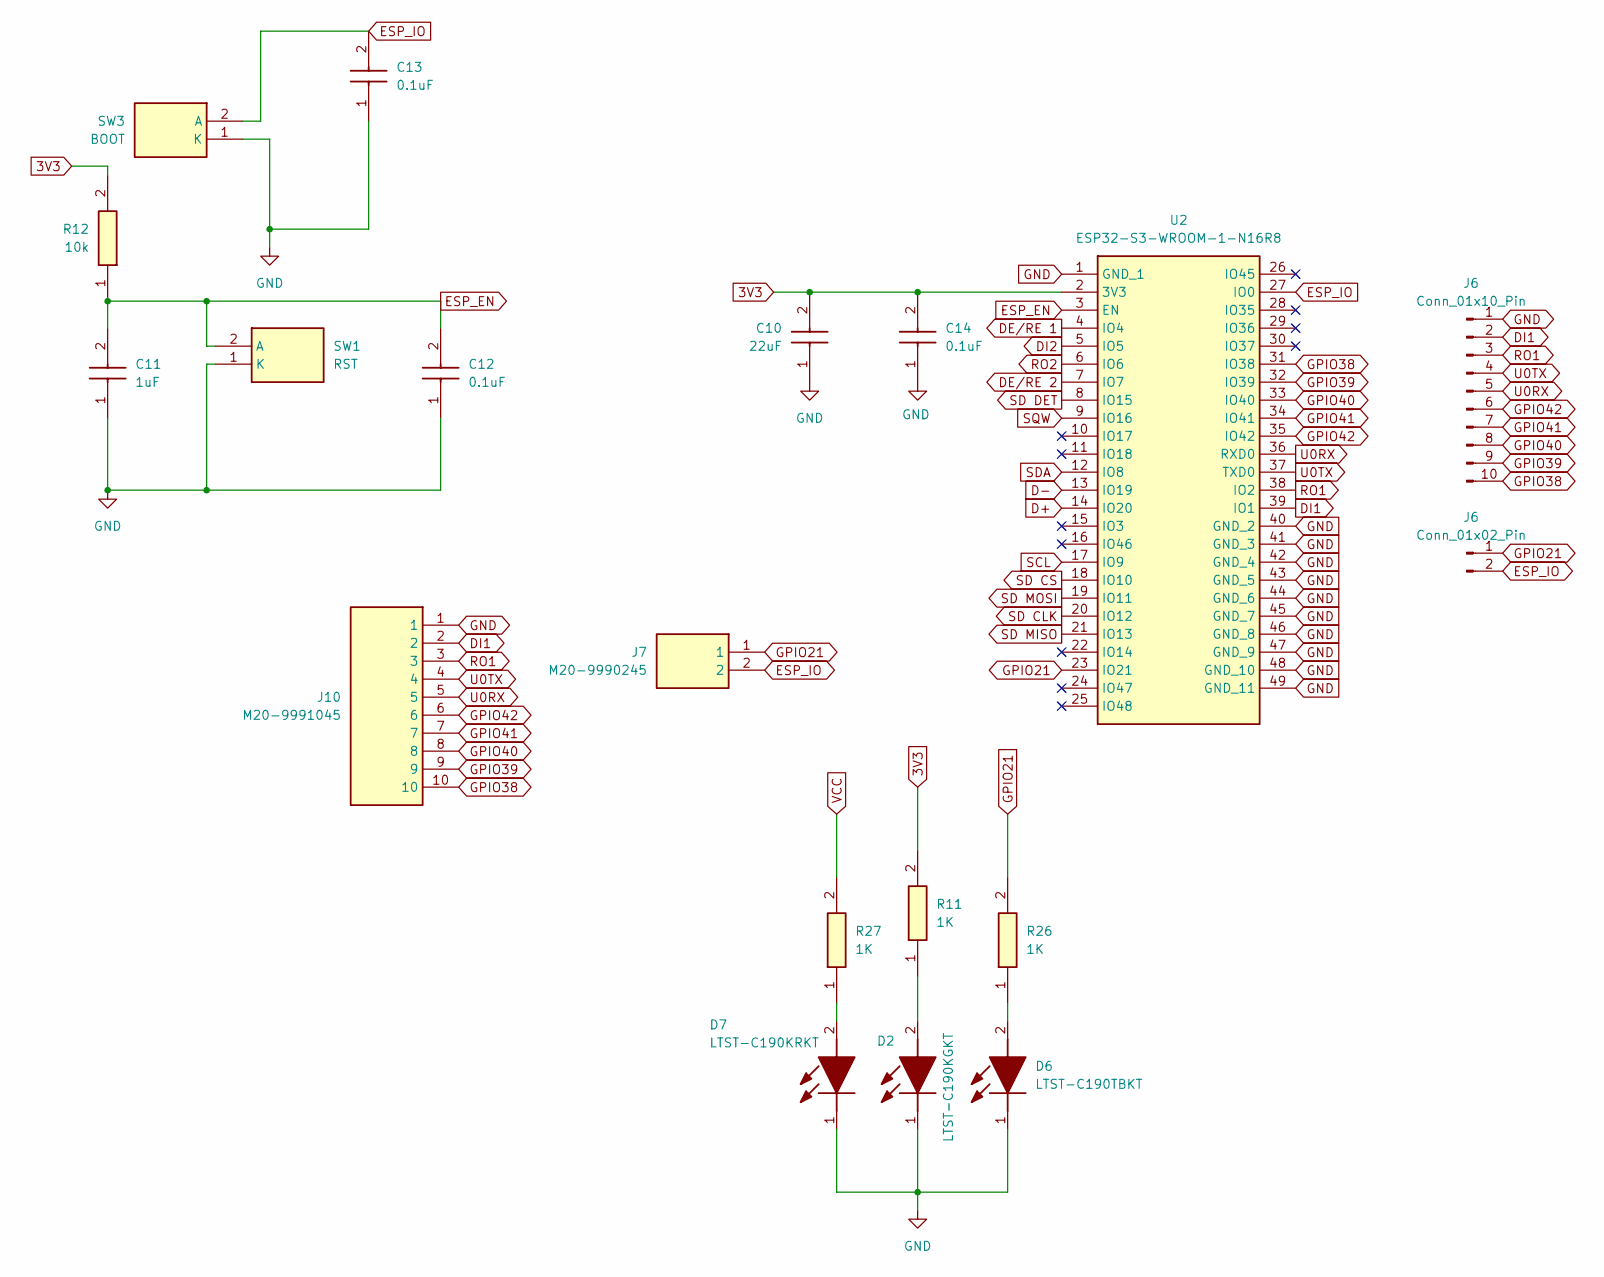
[picture p84: schematic esp32_modulo.kicad_sch]

Parts:
C10: 22uF; GRM21BR60J226ME39L; Mouser Part Number 81-GRM21R60J226ME39L
C11: 1uF; CAPC1608X90N; Mouser Part Number 81-GRM39R105K10
C12, C13, C14: 0.1uF; CAPC1608X90N; Mouser Part Number 81-GCM188R71C104KA7D
D2: LTST-C190KGKT; LEDC1608X80N; Mouser Part Number 859-LTST-C190KGKT
D6: LTST-C190TBKT; LTSTC190TBKT; Mouser Part Number 859-LTST-C190TBKT
D7: LTST-C190KRKT; LEDC1608X80N; Mouser Part Number 859-LTST-C190KRKT
J6: Conn_01x02_Pin; PinHeader_1x02_P2.54mm_Vertical
J7: M20-9990245; HDRV2W64P0X254_1X2_508X254X864P; Mouser Part Number 855-M20-9990245
J10: M20-9991045; HDRV10W64P0X254_1X10_2540X254X864P; Mouser Part Number 855-M20-9991045
R11, R26, R27: 1K; RESC1608X55N; Mouser Part Number 603-RC0603FR-071KL
R12: 10k; RESC1608X55N; Mouser Part Number 603-RC0603FR-0710KL
SW1: RST; B3U-1000P; Mouser Part Number 653-B3U-1000P
SW3: BOOT; B3U-1000P; Mouser Part Number 653-B3U-1000P
U2: ESP32-S3-WROOM-1-N16R8; ESP32S3WROOM1N16R8; Mouser Part Number 356-ESP32S3WRM1N16R8

Connections:
D+: U2.14 (IO20); also elsewhere on the board
D-: U2.13 (IO19); also elsewhere on the board
DE/RE 1: U2.4 (IO4); also elsewhere on the board
DE/RE 2: U2.7 (IO7); also elsewhere on the board
DI1: J6.2, J10.2, U2.39 (IO1); also elsewhere on the board
DI2: U2.5 (IO5); also elsewhere on the board
ESP_EN: C11.2, C12.2, R12.1, SW1.2 (A), U2.3 (EN)
ESP_IO: C13.2, J6.2, J7.2, SW3.2 (A), U2.27 (IO0); also elsewhere on the board
GPIO21: J6.1, J7.1, R26.2, U2.23 (IO21)
GPIO38: J6.10, J10.10, U2.31 (IO38)
GPIO39: J6.9, J10.9, U2.32 (IO39)
GPIO40: J6.8, J10.8, U2.33 (IO40)
GPIO41: J6.7, J10.7, U2.34 (IO41)
GPIO42: J6.6, J10.6, U2.35 (IO42)
unnamed: D2.2 (A), R11.1
unnamed: D6.2 (A), R26.1
unnamed: D7.2 (A), R27.1
RO1: J6.3, J10.3, U2.38 (IO2); also elsewhere on the board
RO2: U2.6 (IO6); also elsewhere on the board
SCL: U2.17 (IO9); also elsewhere on the board
SD CS: U2.18 (IO10); also elsewhere on the board
SD DET: U2.8 (IO15); also elsewhere on the board
SD MISO: U2.21 (IO13); also elsewhere on the board
SD MOSI: U2.19 (IO11); also elsewhere on the board
SDA: U2.12 (IO8); also elsewhere on the board
SQW: U2.9 (IO16); also elsewhere on the board
U0RX: J6.5, J10.5, U2.36 (RXD0)
U0TX: J6.4, J10.4, U2.37 (TXD0)
VCC: R27.2; also elsewhere on the board

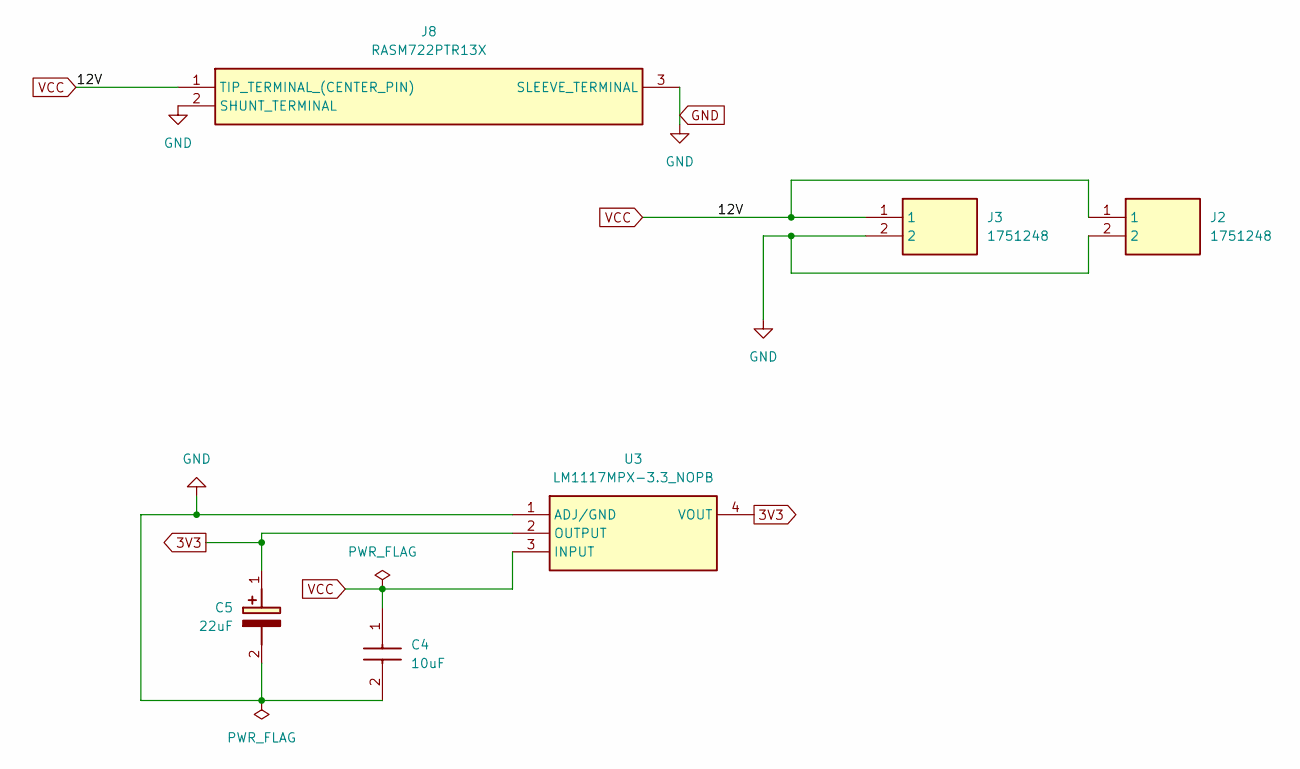
[picture p85: schematic vcc_to_3v3.kicad_sch]

Parts:
C4: 10uF; CAPC3216X229N; Mouser Part Number 581-12063C106KAT2A
C5: 22uF; T495C; Manufacturer_Part_Number T495C226K025AHE300
J2, J3: 1751248; Mouser Part Number 651-1751248
J8: RASM722PTR13X; RASM722X; Mouser Part Number 502-RASM722PTR13X
U3: LM1117MPX-3.3_NOPB; SOT230P700X180-4N; Mouser Part Number 926-LM1117MPX3.3NOPB

Connections:
VCC: C4.1, J2.1, J3.1, J8.1 (TIP_TERMINAL_(CENTER_PIN)), U3.3 (INPUT); also elsewhere on the board

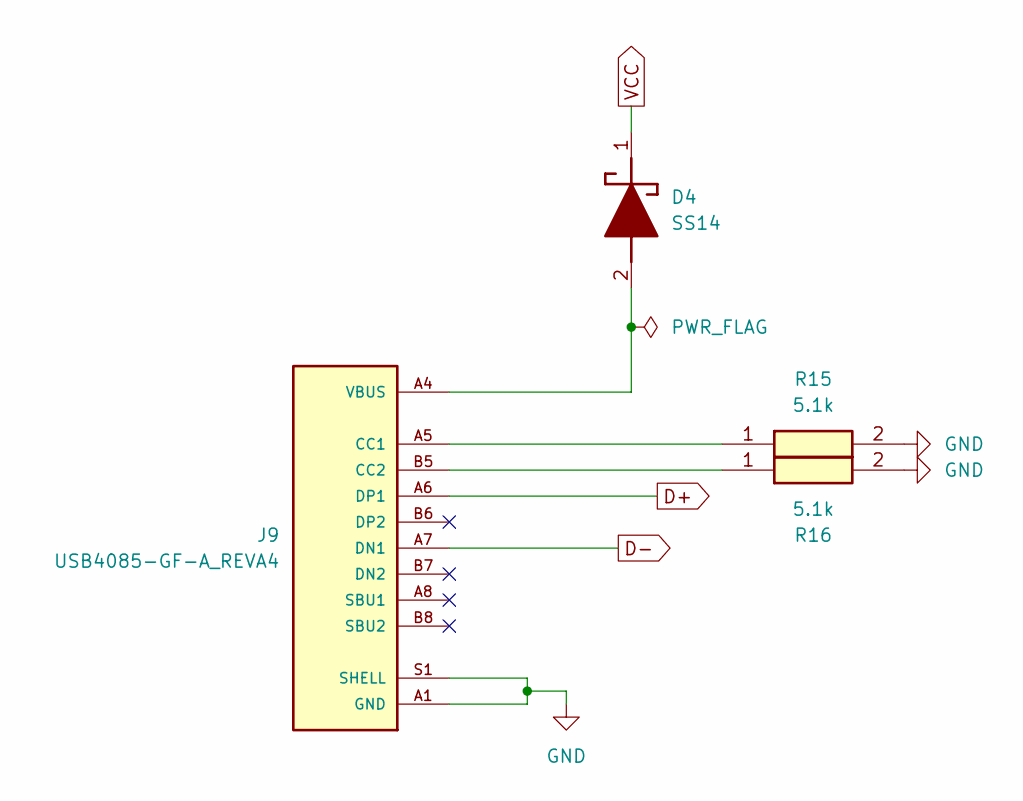
[picture p86: schematic conector_USB.kicad_sch]

Parts:
D4: SS14; DIOM5227X270N; Mouser Part Number 512-SS14
J9: USB4085-GF-A_REVA4; GCT_USB4085-GF-A_REVA4; PARTREV A4
R15, R16: 5.1k; RESC1608X55N; Mouser Part Number 603-RC0603FR-075K1L

Connections:
D+: J9.A6 (DP1); also elsewhere on the board
D-: J9.A7 (DN1); also elsewhere on the board
unnamed: J9.A5 (CC1), R15.1
unnamed: J9.B5 (CC2), R16.1
VBUS: D4.2 (A), J9.A4 (VBUS), J9.A9 (VBUS), J9.B4 (VBUS), J9.B9 (VBUS)
VCC: D4.1 (K); also elsewhere on the board

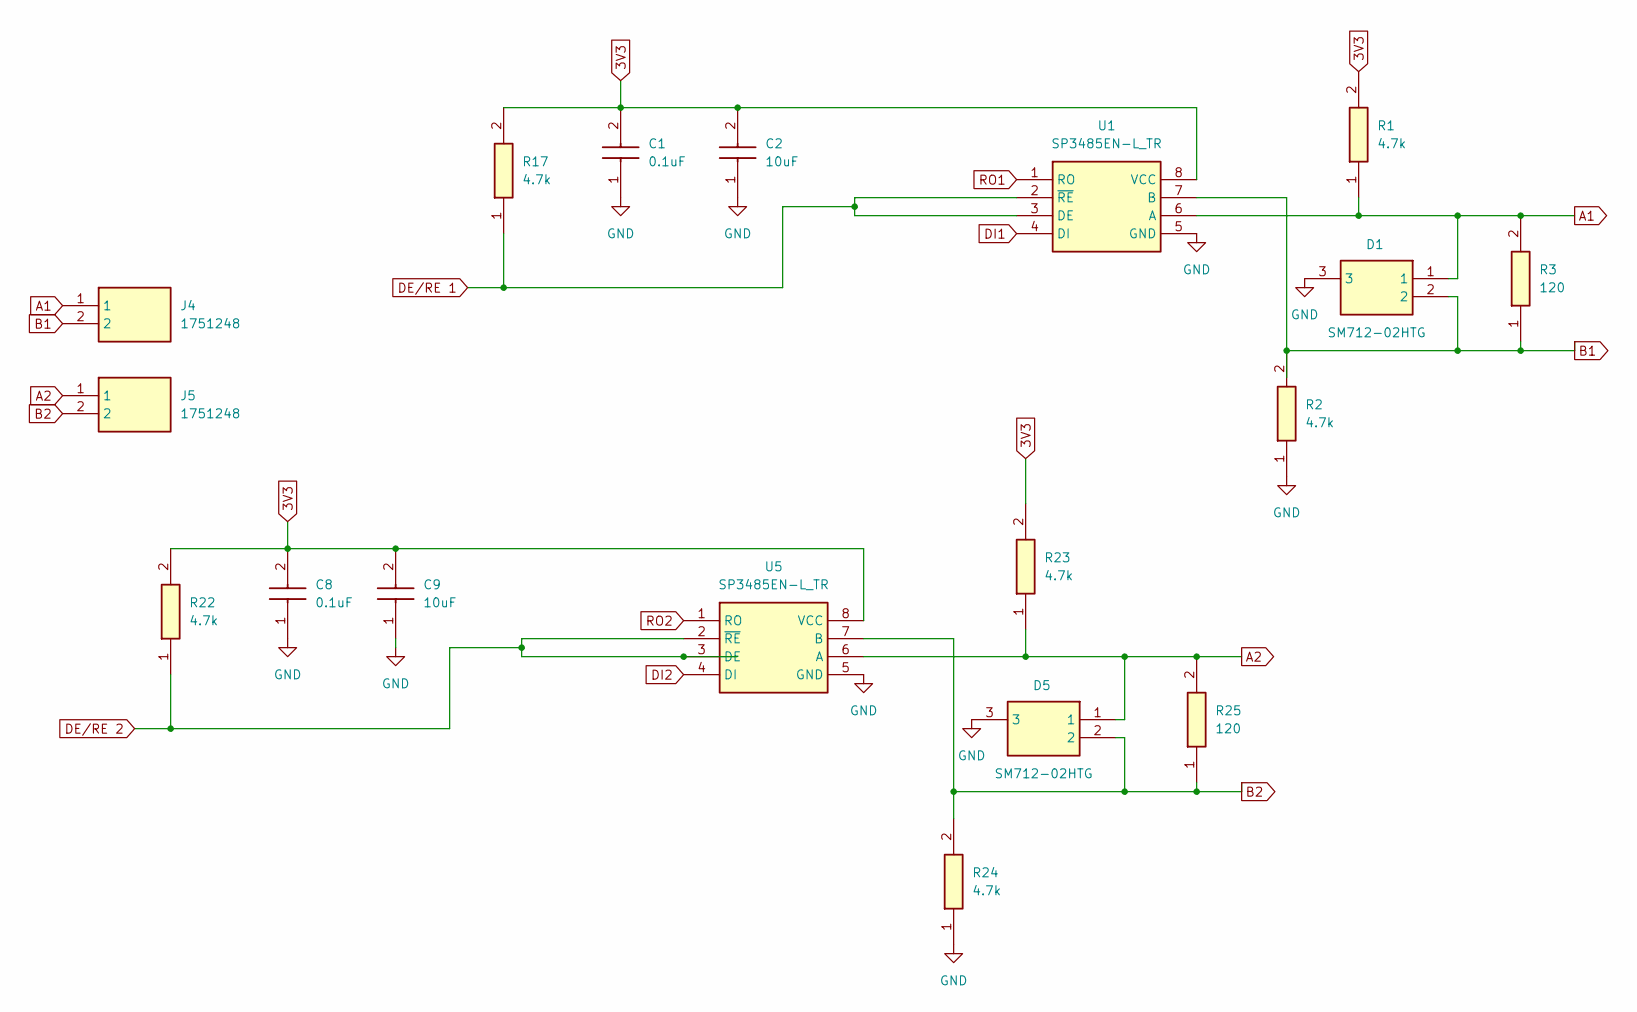
[picture p87: schematic ttl_to_rs485.kicad_sch]

Parts:
C1, C8: 0.1uF; CAPC1608X90N; Mouser Part Number 81-GCM188R71C104KA7D
C2, C9: 10uF; GRT21BR61A106KE01L; Mouser Part Number 81-GRT21BR61A106KE1L
D1, D5: SM712-02HTG; SM71202HTG; Mouser Part Number 576-SM712-02HTG
J4, J5: 1751248; Mouser Part Number 651-1751248
R1, R2, R17, R22, R23, R24: 4.7k; RESC1608X55N; Mouser Part Number 603-RC0603FR-074K7L
R3, R25: 120; RESC1608X55N; Mouser Part Number 603-RC0603FR-07120RL
U1, U5: SP3485EN-L_TR; SOIC127P600X175-8N; Mouser Part Number 701-SP3485EN-L/TR

Connections:
A1: D1.1, J4.1, R1.1, R3.2, U1.6 (A)
A2: D5.1, J5.1, R23.1, R25.2, U5.6 (A)
B1: D1.2, J4.2, R2.2, R3.1, U1.7 (B)
B2: D5.2, J5.2, R24.2, R25.1, U5.7 (B)
DE/RE 1: R17.1, U1.2 (~RE), U1.3 (DE); also elsewhere on the board
DE/RE 2: R22.1, U5.2 (~RE), U5.3 (DE); also elsewhere on the board
DI1: U1.4 (DI); also elsewhere on the board
DI2: U5.4 (DI); also elsewhere on the board
RO1: U1.1 (RO); also elsewhere on the board
RO2: U5.1 (RO); also elsewhere on the board

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
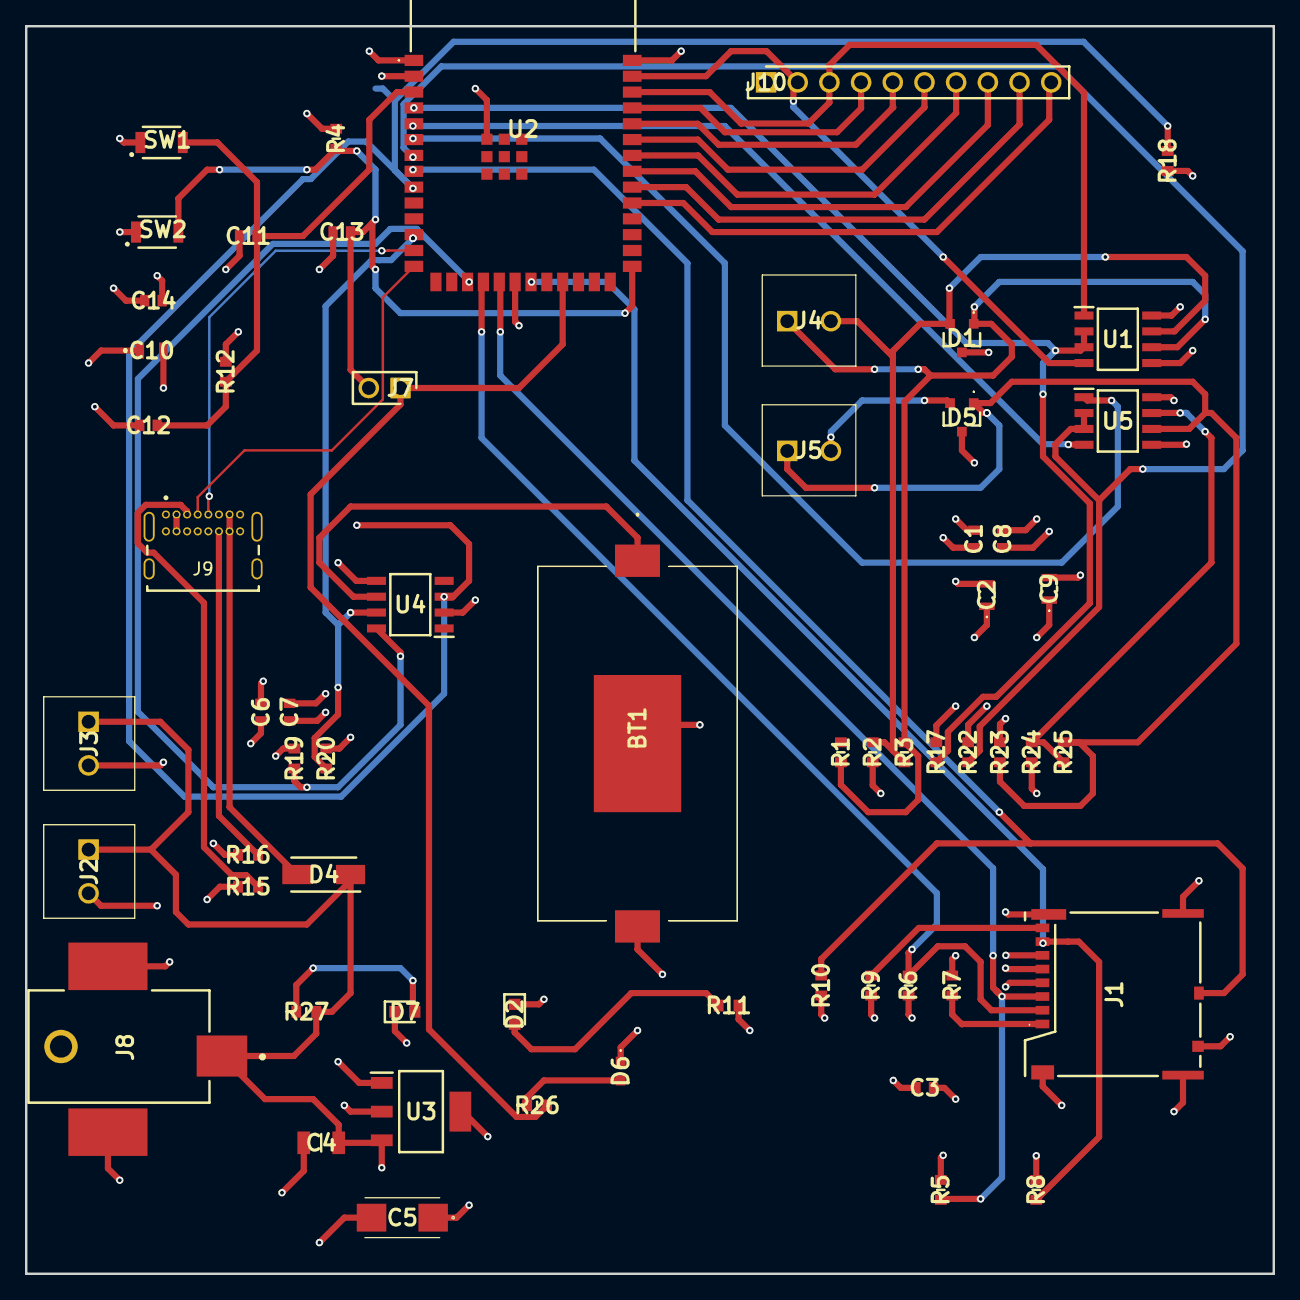
[picture p88: board Estacion_Nivel.kicad_pcb from above]

Board: 4 copper layers, 100.0 x 100.0 mm, 61 parts (0 on the bottom side), 41 nets.

Other parts of the board:
R4: 10k; RESC1608X55N
SW2: BOOT; B3U-1000P

Their connections:
ESP_IO: R4.1, SW2.2 (A); also elsewhere on the board
