HecVelaz/Proyecto-Mburica-/02_Estacion/Proyecto3__Sistema_de_adquisiscion_de_Nivel/Hardware_Kicad/V2_Estacion_Nivel/V2_Estacion_Nviel.kicad_pcb

## KiCad design 02_Estacion/Proyecto3__Sistema_de_adquisiscion_de_Nivel/Hardware_Kicad/V2_Estacion_Nivel/V2_Estacion_Nviel.kicad_pcb (2026-04-18)

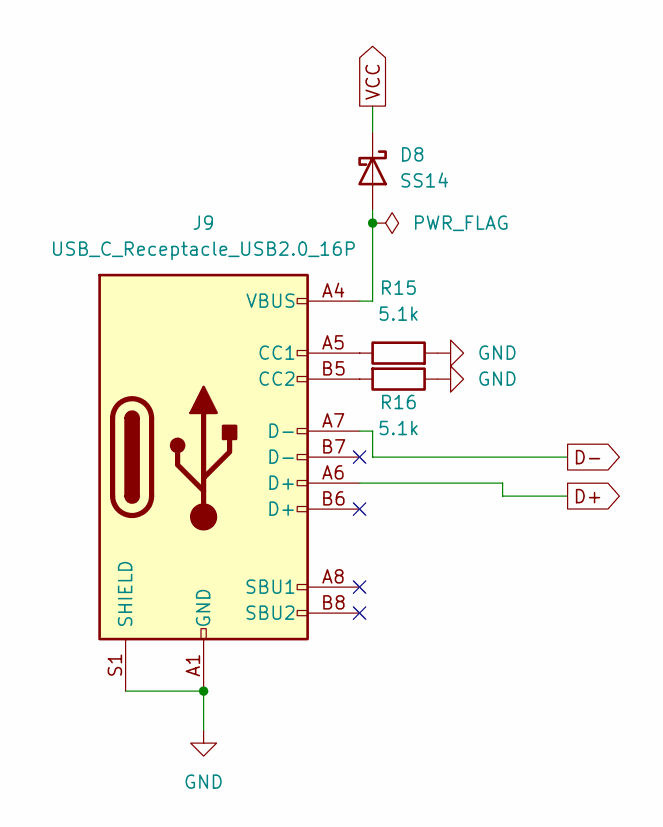
[picture p89: schematic conector_USB.kicad_sch]

Parts:
D8: SS14; D_SMA
J9: USB_C_Receptacle_USB2.0_16P; USB_C_Receptacle_Palconn_UTC16-G
R15, R16: 5.1k; R_0805_2012Metric_Pad1.20x1.40mm_HandSolder

Connections:
D+: J9.A6 (D+); also elsewhere on the board
D-: J9.A7 (D-); also elsewhere on the board
GND: J9.A1 (GND), J9.A12 (GND), J9.B1 (GND), J9.B12 (GND), J9.S1 (SHIELD), R15.2, R16.1; also elsewhere on the board
unnamed: D8.2 (A), J9.A4 (VBUS), J9.A9 (VBUS), J9.B4 (VBUS), J9.B9 (VBUS)
unnamed: J9.A5 (CC1), R15.1
unnamed: J9.B5 (CC2), R16.2
VCC: D8.1 (K); also elsewhere on the board

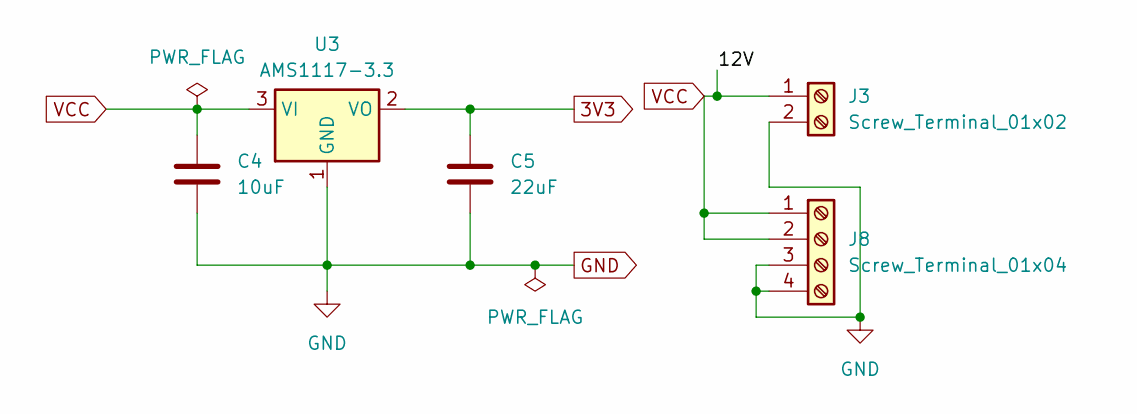
[picture p90: schematic vcc_to_3v3.kicad_sch]

Parts:
C4: 10uF; C_0805_2012Metric_Pad1.18x1.45mm_HandSolder
C5: 22uF; C_0805_2012Metric_Pad1.18x1.45mm_HandSolder
J3: Screw_Terminal_01x02; TerminalBlock_MaiXu_MX126-5.0-02P_1x02_P5.00mm
J8: Screw_Terminal_01x04; TerminalBlock_MaiXu_MX126-5.0-04P_1x04_P5.00mm
U3: AMS1117-3.3; SOT-223-3_TabPin2

Connections:
3V3: C5.2, U3.2 (VO); also elsewhere on the board
GND: C4.1, C5.1, J3.2, J8.3, J8.4, U3.1 (GND); also elsewhere on the board
VCC: C4.2, J3.1, J8.1, J8.2, U3.3 (VI); also elsewhere on the board

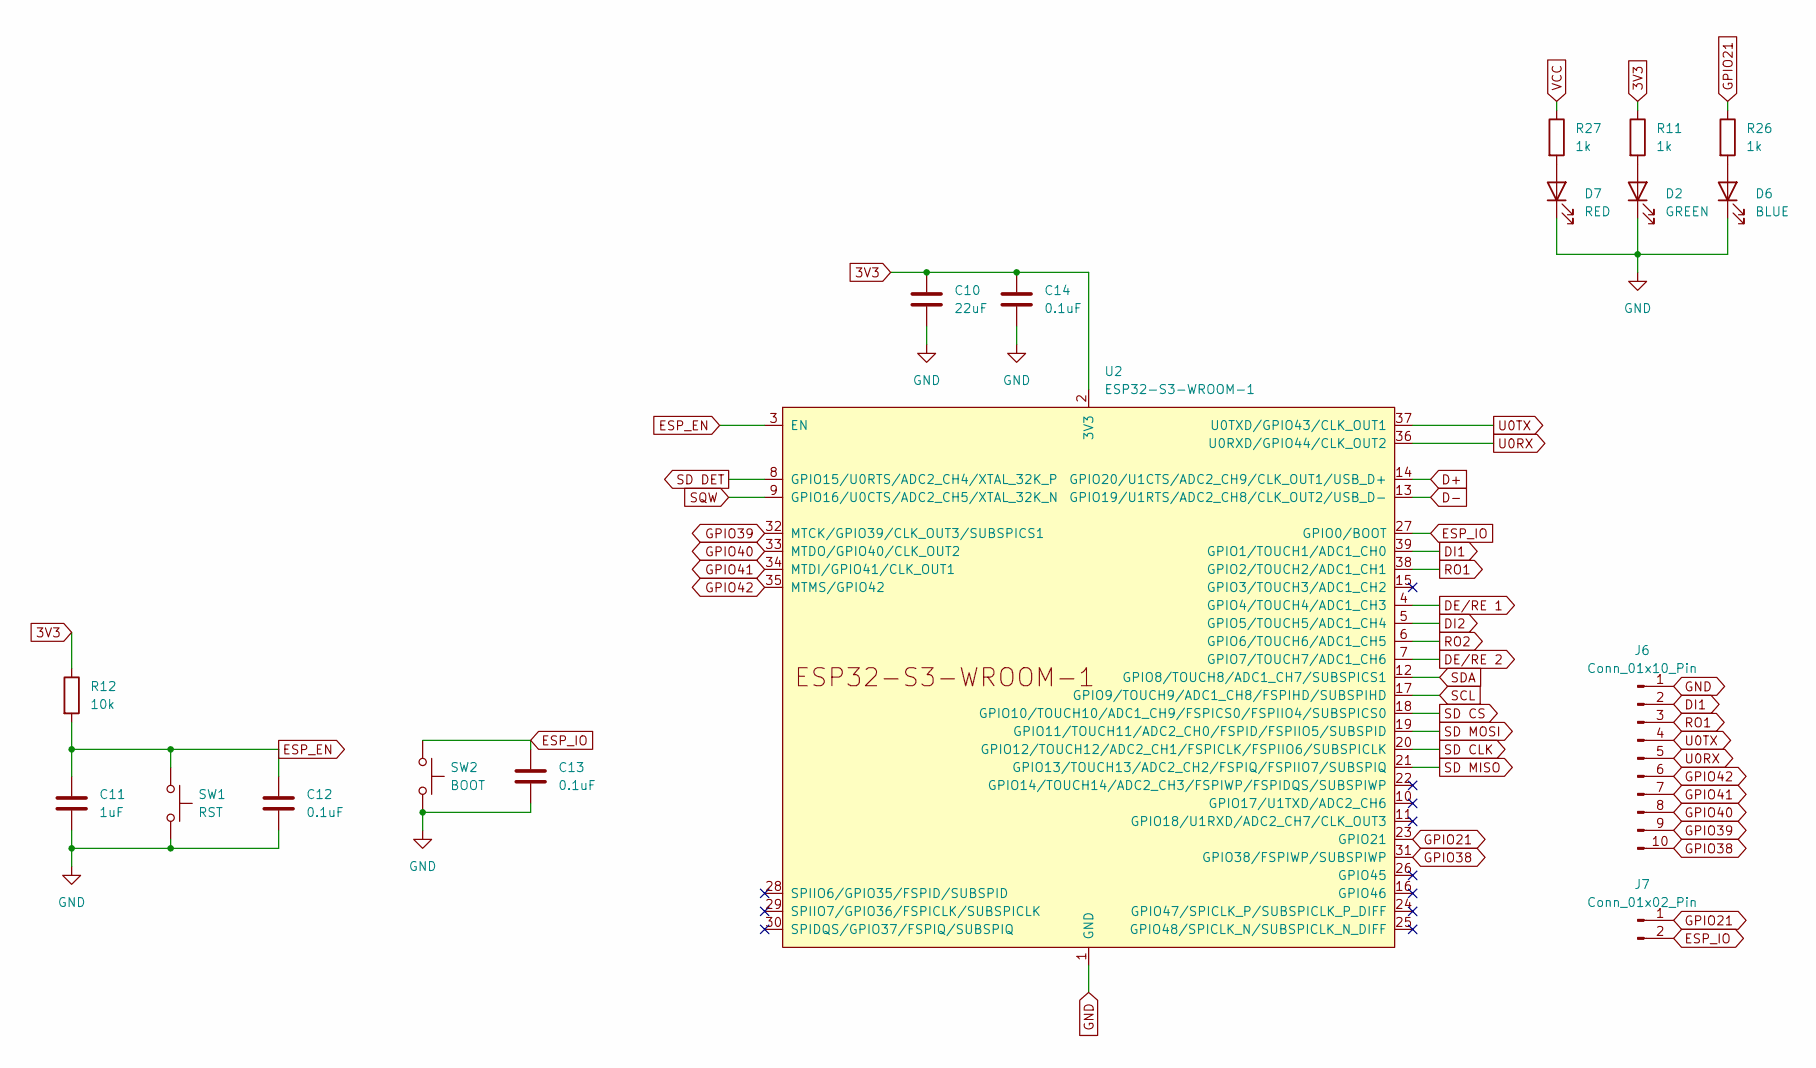
[picture p91: schematic esp32_modulo.kicad_sch]

Parts:
C10: 22uF; C_0805_2012Metric_Pad1.18x1.45mm_HandSolder
C11: 1uF; C_0805_2012Metric_Pad1.18x1.45mm_HandSolder
C12, C13, C14: 0.1uF; C_0805_2012Metric_Pad1.18x1.45mm_HandSolder
D2: GREEN; LED_0805_2012Metric_Pad1.15x1.40mm_HandSolder
D6: BLUE; LED_0805_2012Metric_Pad1.15x1.40mm_HandSolder
D7: RED; LED_0805_2012Metric_Pad1.15x1.40mm_HandSolder
J6: Conn_01x10_Pin; PinHeader_1x10_P2.54mm_Vertical
J7: Conn_01x02_Pin; PinHeader_1x02_P2.54mm_Vertical
R11, R26, R27: 1k; R_0805_2012Metric_Pad1.20x1.40mm_HandSolder
R12: 10k; R_0805_2012Metric_Pad1.20x1.40mm_HandSolder
SW1: RST; SW_Push_1P1T_NO_CK_KMR2
SW2: BOOT; SW_Push_1P1T_NO_CK_KMR2
U2: ESP32-S3-WROOM-1

Connections:
3V3: C10.2, C14.2, R11.1, R12.1, U2.2 (3V3); also elsewhere on the board
D+: U2.14 (GPIO20/U1CTS/ADC2_CH9/CLK_OUT1/USB_D+); also elsewhere on the board
D-: U2.13 (GPIO19/U1RTS/ADC2_CH8/CLK_OUT2/USB_D-); also elsewhere on the board
DE/RE 1: U2.4 (GPIO4/TOUCH4/ADC1_CH3); also elsewhere on the board
DE/RE 2: U2.7 (GPIO7/TOUCH7/ADC1_CH6); also elsewhere on the board
DI1: J6.2, U2.39 (GPIO1/TOUCH1/ADC1_CH0); also elsewhere on the board
DI2: U2.5 (GPIO5/TOUCH5/ADC1_CH4); also elsewhere on the board
ESP_EN: C11.2, C12.2, R12.2, SW1.1, U2.3 (EN)
ESP_IO: C13.2, J7.2, SW2.1, U2.27 (GPIO0/BOOT)
GND: C10.1, C11.1, C12.1, C13.1, C14.1, D2.1 (K), D6.1 (K), D7.1 (K), J6.1, SW1.2, SW2.2, U2.1 (GND), U2.40 (GND), U2.41 (GND); also elsewhere on the board
GPIO21: J7.1, R26.1, U2.23 (GPIO21)
GPIO38: J6.10, U2.31 (GPIO38/FSPIWP/SUBSPIWP)
GPIO39: J6.9, U2.32 (MTCK/GPIO39/CLK_OUT3/SUBSPICS1)
GPIO40: J6.8, U2.33 (MTDO/GPIO40/CLK_OUT2)
GPIO41: J6.7, U2.34 (MTDI/GPIO41/CLK_OUT1)
GPIO42: J6.6, U2.35 (MTMS/GPIO42)
unnamed: D2.2 (A), R11.2
unnamed: D6.2 (A), R26.2
unnamed: D7.2 (A), R27.2
RO1: J6.3, U2.38 (GPIO2/TOUCH2/ADC1_CH1); also elsewhere on the board
RO2: U2.6 (GPIO6/TOUCH6/ADC1_CH5); also elsewhere on the board
SCL: U2.17 (GPIO9/TOUCH9/ADC1_CH8/FSPIHD/SUBSPIHD); also elsewhere on the board
SD CLK: U2.20 (GPIO12/TOUCH12/ADC2_CH1/FSPICLK/FSPIIO6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); also elsewhere on the board
SD CS: U2.18 (GPIO10/TOUCH10/ADC1_CH9/FSPICS0/FSPIIO4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); also elsewhere on the board
SD DET: U2.8 (GPIO15/U0RTS/ADC2_CH4/XTAL_32K_P); also elsewhere on the board
SD MISO: U2.21 (GPIO13/TOUCH13/ADC2_CH2/FSPIQ/FSPIIO7/S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); also elsewhere on the board
SD MOSI: U2.19 (GPIO11/TOUCH11/ADC2_CH0/FSPID/FSPIIO5/S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); also elsewhere on the board
SDA: U2.12 (GPIO8/TOUCH8/ADC1_CH7/SUBSPICS1); also elsewhere on the board
SQW: U2.9 (GPIO16/U0CTS/ADC2_CH5/XTAL_32K_N); also elsewhere on the board
U0RX: J6.5, U2.36 (U0RXD/GPIO44/CLK_OUT2)
U0TX: J6.4, U2.37 (U0TXD/GPIO43/CLK_OUT1)
VCC: R27.1; also elsewhere on the board

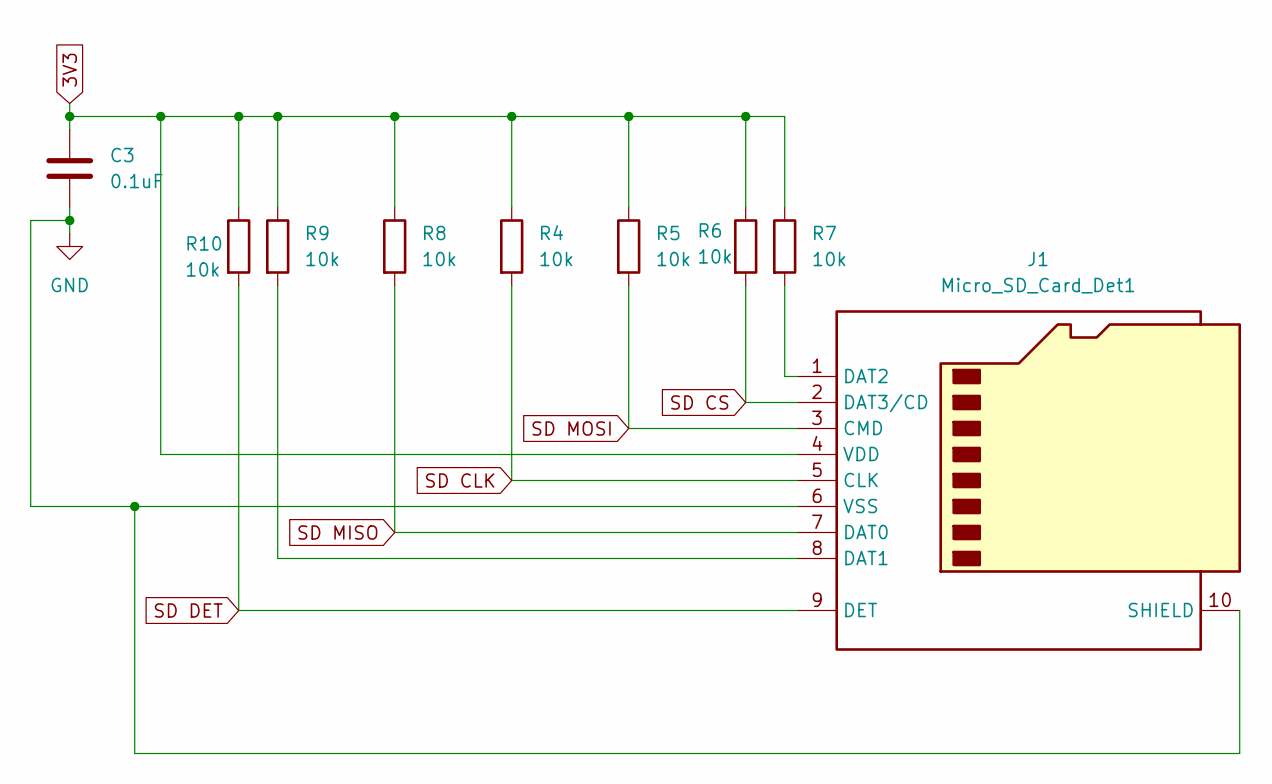
[picture p92: schematic sd_to_esp32.kicad_sch]

Parts:
C3: 0.1uF; C_0805_2012Metric_Pad1.18x1.45mm_HandSolder
J1: Micro_SD_Card_Det1; microSD_HC_Molex_104031-0811
R4, R5, R6, R7, R8, R9, R10: 10k; R_0805_2012Metric_Pad1.20x1.40mm_HandSolder

Connections:
3V3: C3.2, J1.4 (VDD), R4.1, R5.1, R6.1, R7.1, R8.1, R9.1, R10.1; also elsewhere on the board
GND: C3.1, J1.6 (VSS), J1.10 (SHIELD); also elsewhere on the board
unnamed: J1.8 (DAT1), R9.2
unnamed: J1.1 (DAT2), R7.2
SD CLK: J1.5 (CLK), R4.2; also elsewhere on the board
SD CS: J1.2 (DAT3/CD), R6.2; also elsewhere on the board
SD DET: J1.9 (DET), R10.2; also elsewhere on the board
SD MISO: J1.7 (DAT0), R8.2; also elsewhere on the board
SD MOSI: J1.3 (CMD), R5.2; also elsewhere on the board

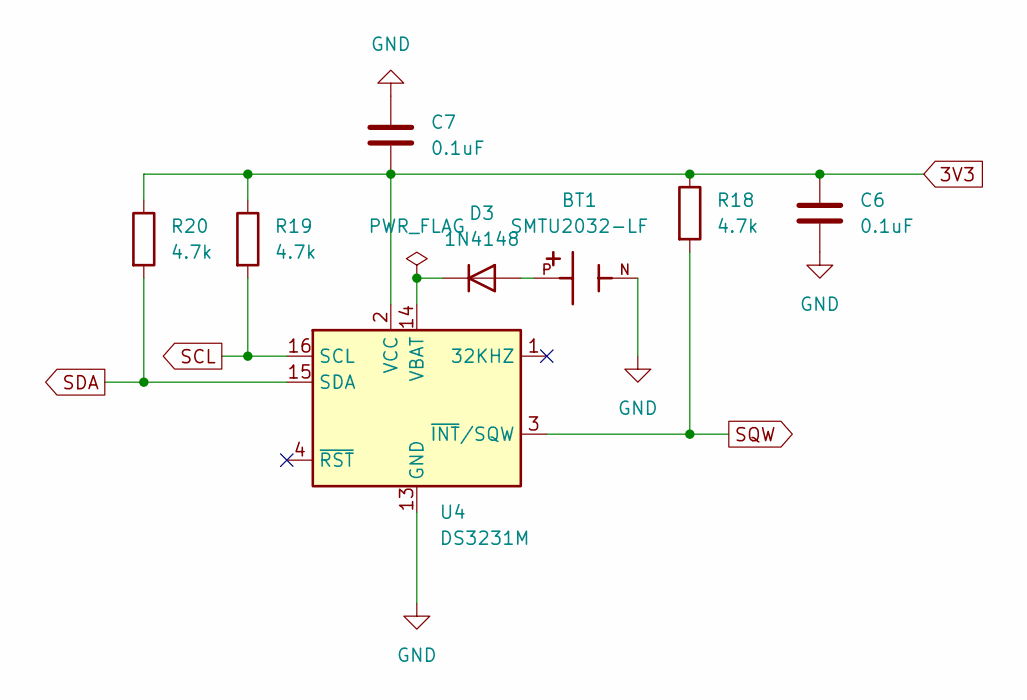
[picture p93: schematic DS3231.kicad_sch]

Parts:
BT1: SMTU2032-LF; BAT_SMTU2032-LF; PARTREV 3
C6, C7: 0.1uF; C_0805_2012Metric_Pad1.18x1.45mm_HandSolder
D3: 1N4148; D_SOD-123
R18, R19, R20: 4.7k; R_0805_2012Metric_Pad1.20x1.40mm_HandSolder
U4: DS3231M; SOIC-16W_7.5x10.3mm_P1.27mm

Connections:
3V3: C6.2, C7.1, R18.1, R19.1, R20.1, U4.2 (VCC); also elsewhere on the board
GND: BT1.N, C6.1, C7.2, U4.5 (GND), U4.6 (GND), U4.7 (GND), U4.8 (GND), U4.9 (GND), U4.10 (GND), U4.11 (GND), U4.12 (GND), U4.13 (GND); also elsewhere on the board
unnamed: BT1.P, D3.2 (A)
unnamed: D3.1 (K), U4.14 (VBAT)
SCL: R19.2, U4.16 (SCL); also elsewhere on the board
SDA: R20.2, U4.15 (SDA); also elsewhere on the board
SQW: R18.2, U4.3 (~INT/SQW); also elsewhere on the board

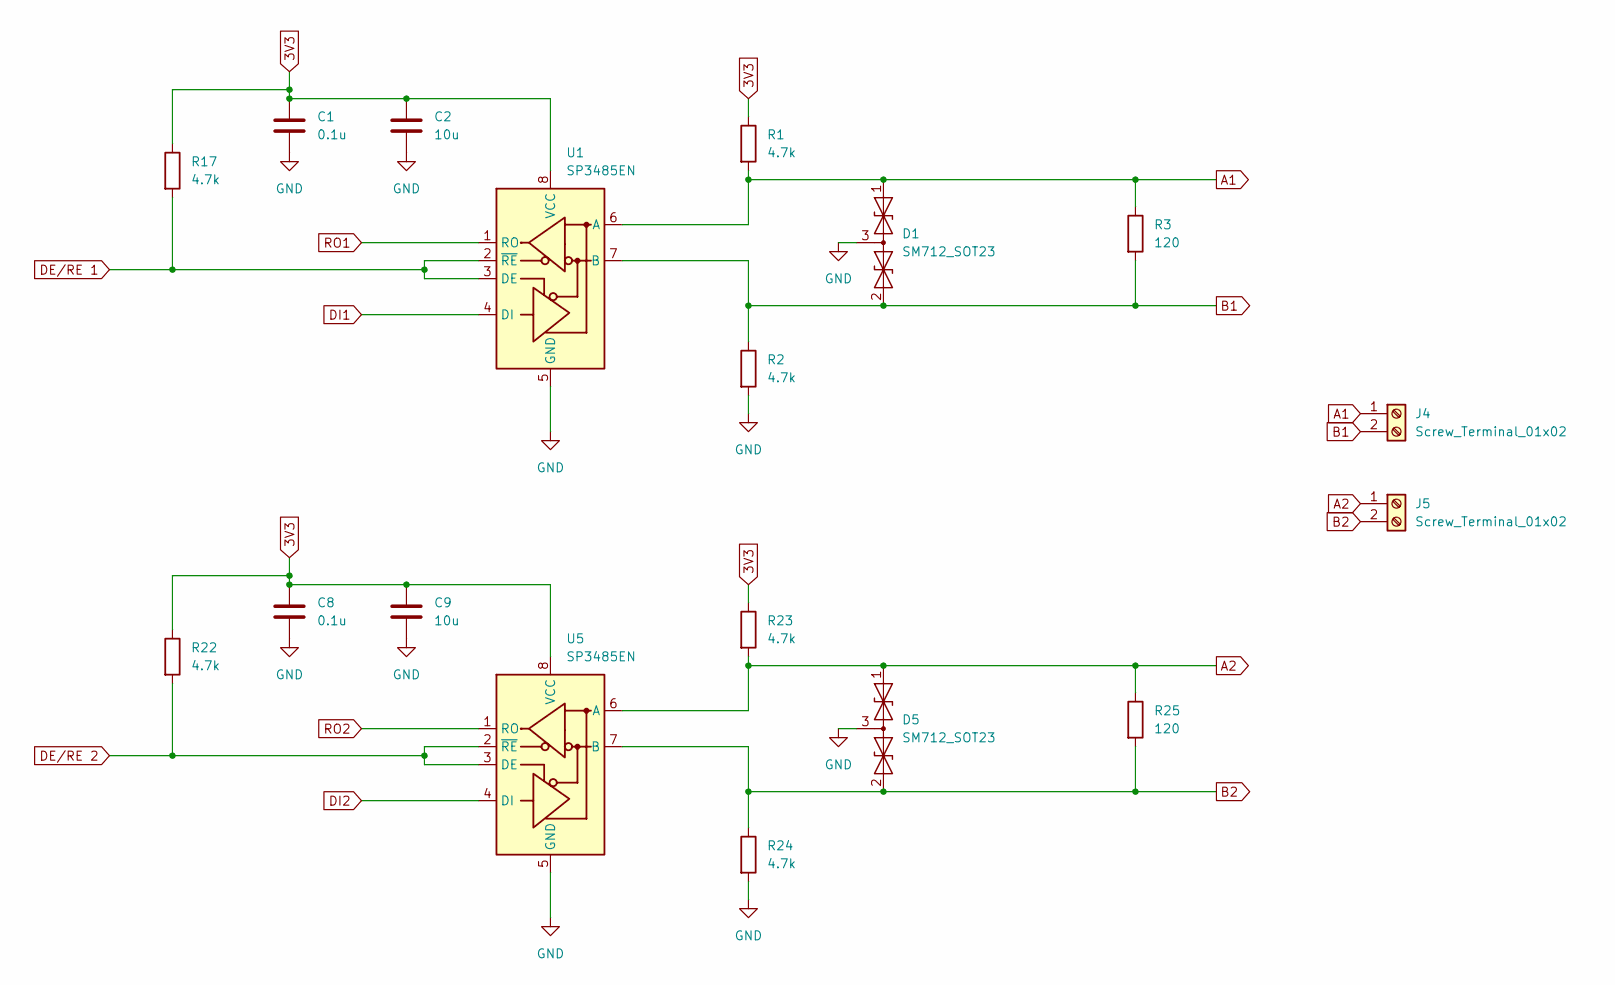
[picture p94: schematic ttl_to_rs485.kicad_sch]

Parts:
C1, C8: 0.1u; C_0805_2012Metric_Pad1.18x1.45mm_HandSolder
C2, C9: 10u; C_0805_2012Metric_Pad1.18x1.45mm_HandSolder
D1, D5: SM712_SOT23; SOT-23
J4, J5: Screw_Terminal_01x02; TerminalBlock_MaiXu_MX126-5.0-02P_1x02_P5.00mm
R1, R2, R17, R22, R23, R24: 4.7k; R_0805_2012Metric_Pad1.20x1.40mm_HandSolder
R3, R25: 120; R_0805_2012Metric_Pad1.20x1.40mm_HandSolder
U1, U5: SP3485EN; SOIC-8_3.9x4.9mm_P1.27mm

Connections:
3V3: C1.1, C2.1, C8.1, C9.1, R1.1, R17.1, R22.1, R23.1, U1.8 (VCC), U5.8 (VCC); also elsewhere on the board
A1: D1.1 (A1), J4.1, R1.2, R3.1, U1.6 (A)
A2: D5.1 (A1), J5.1, R23.2, R25.1, U5.6 (A)
B1: D1.2 (A2), J4.2, R2.1, R3.2, U1.7 (B)
B2: D5.2 (A2), J5.2, R24.1, R25.2, U5.7 (B)
DE/RE 1: R17.2, U1.2 (~RE), U1.3 (DE); also elsewhere on the board
DE/RE 2: R22.2, U5.2 (~RE), U5.3 (DE); also elsewhere on the board
DI1: U1.4 (DI); also elsewhere on the board
DI2: U5.4 (DI); also elsewhere on the board
GND: C1.2, C2.2, C8.2, C9.2, D1.3 (common), D5.3 (common), R2.2, R24.2, U1.5 (GND), U5.5 (GND); also elsewhere on the board
RO1: U1.1 (RO); also elsewhere on the board
RO2: U5.1 (RO); also elsewhere on the board
