HecVelaz/Proyecto-Mburica-/02_Estacion/Proyecto3__Sistema_de_adquisiscion_de_Nivel/Hardware_Kicad/V2_Estacion_Nivel/V2_Estacion_Nviel.kicad_pcb

## KiCad design 02_Estacion/Proyecto3__Sistema_de_adquisiscion_de_Nivel/Hardware_Kicad/V2_Estacion_Nivel/V2_Estacion_Nviel.kicad_pcb (continued)

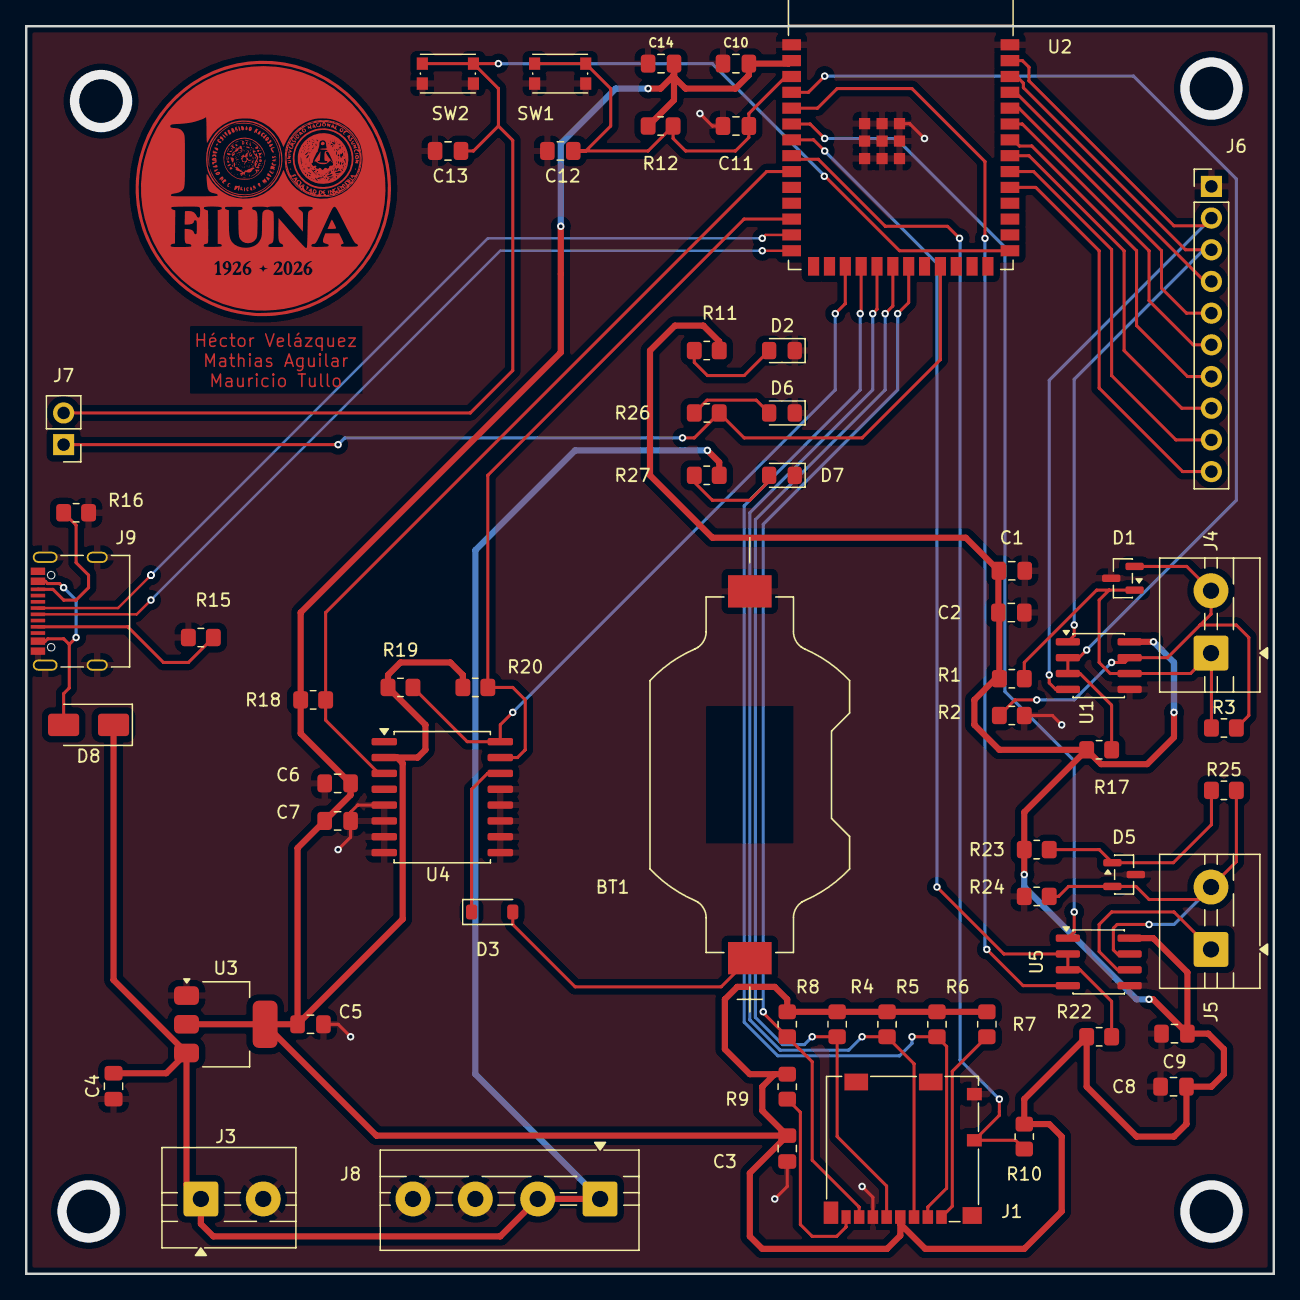
[picture p95: board V2_Estacion_Nviel.kicad_pcb from above]

Board: 2 copper layers, 100.0 x 100.0 mm, 61 parts (0 on the bottom side), 43 nets.
