HecVelaz/Proyecto-Mburica-/(commit log)

2026-07-13 update marzo
    [Mburicao_Marzo_5min.csv, Mburicao_Marzo_5min.xlsx]
2026-07-13 update abril
    [Mburicao_Abril_5min.csv, Mburicao_Abril_5min.xlsx]
2026-07-13 update mayo
    [Mburicao_Mayo_5min.csv, Mburicao_Mayo_5min.xlsx]
2026-07-13 updtae completo
    [Mburicao_sept(2025)_a_may(2026)_5min.xlsx, Mburicao_sept(2025)_a_may(2026)__5min.csv]
2026-07-13 update completo
    [Mburicao_sept(2025)_a_may(2026)_5min.xlsx, Mburicao_sept(2025)_a_may(2026)__5min.csv]
